antmicro/snapdragon-845-baseboard/(threads)

Thread 2 (2024-04-30):

turbox d845

dzid26, 2024-04-30:
Is it compatible with [turbox d845 som](https://www.thundercomm.com/product/d845-som/)?

pkatarzynski, 2024-05-06:
We have not tested the board with Turbox D845 but this SOM should be pin-compatible

Closed 2024-05-06.
