antmicro/snapdragon-845-baseboard/doc/sa800u-baseboard-hw.pdf

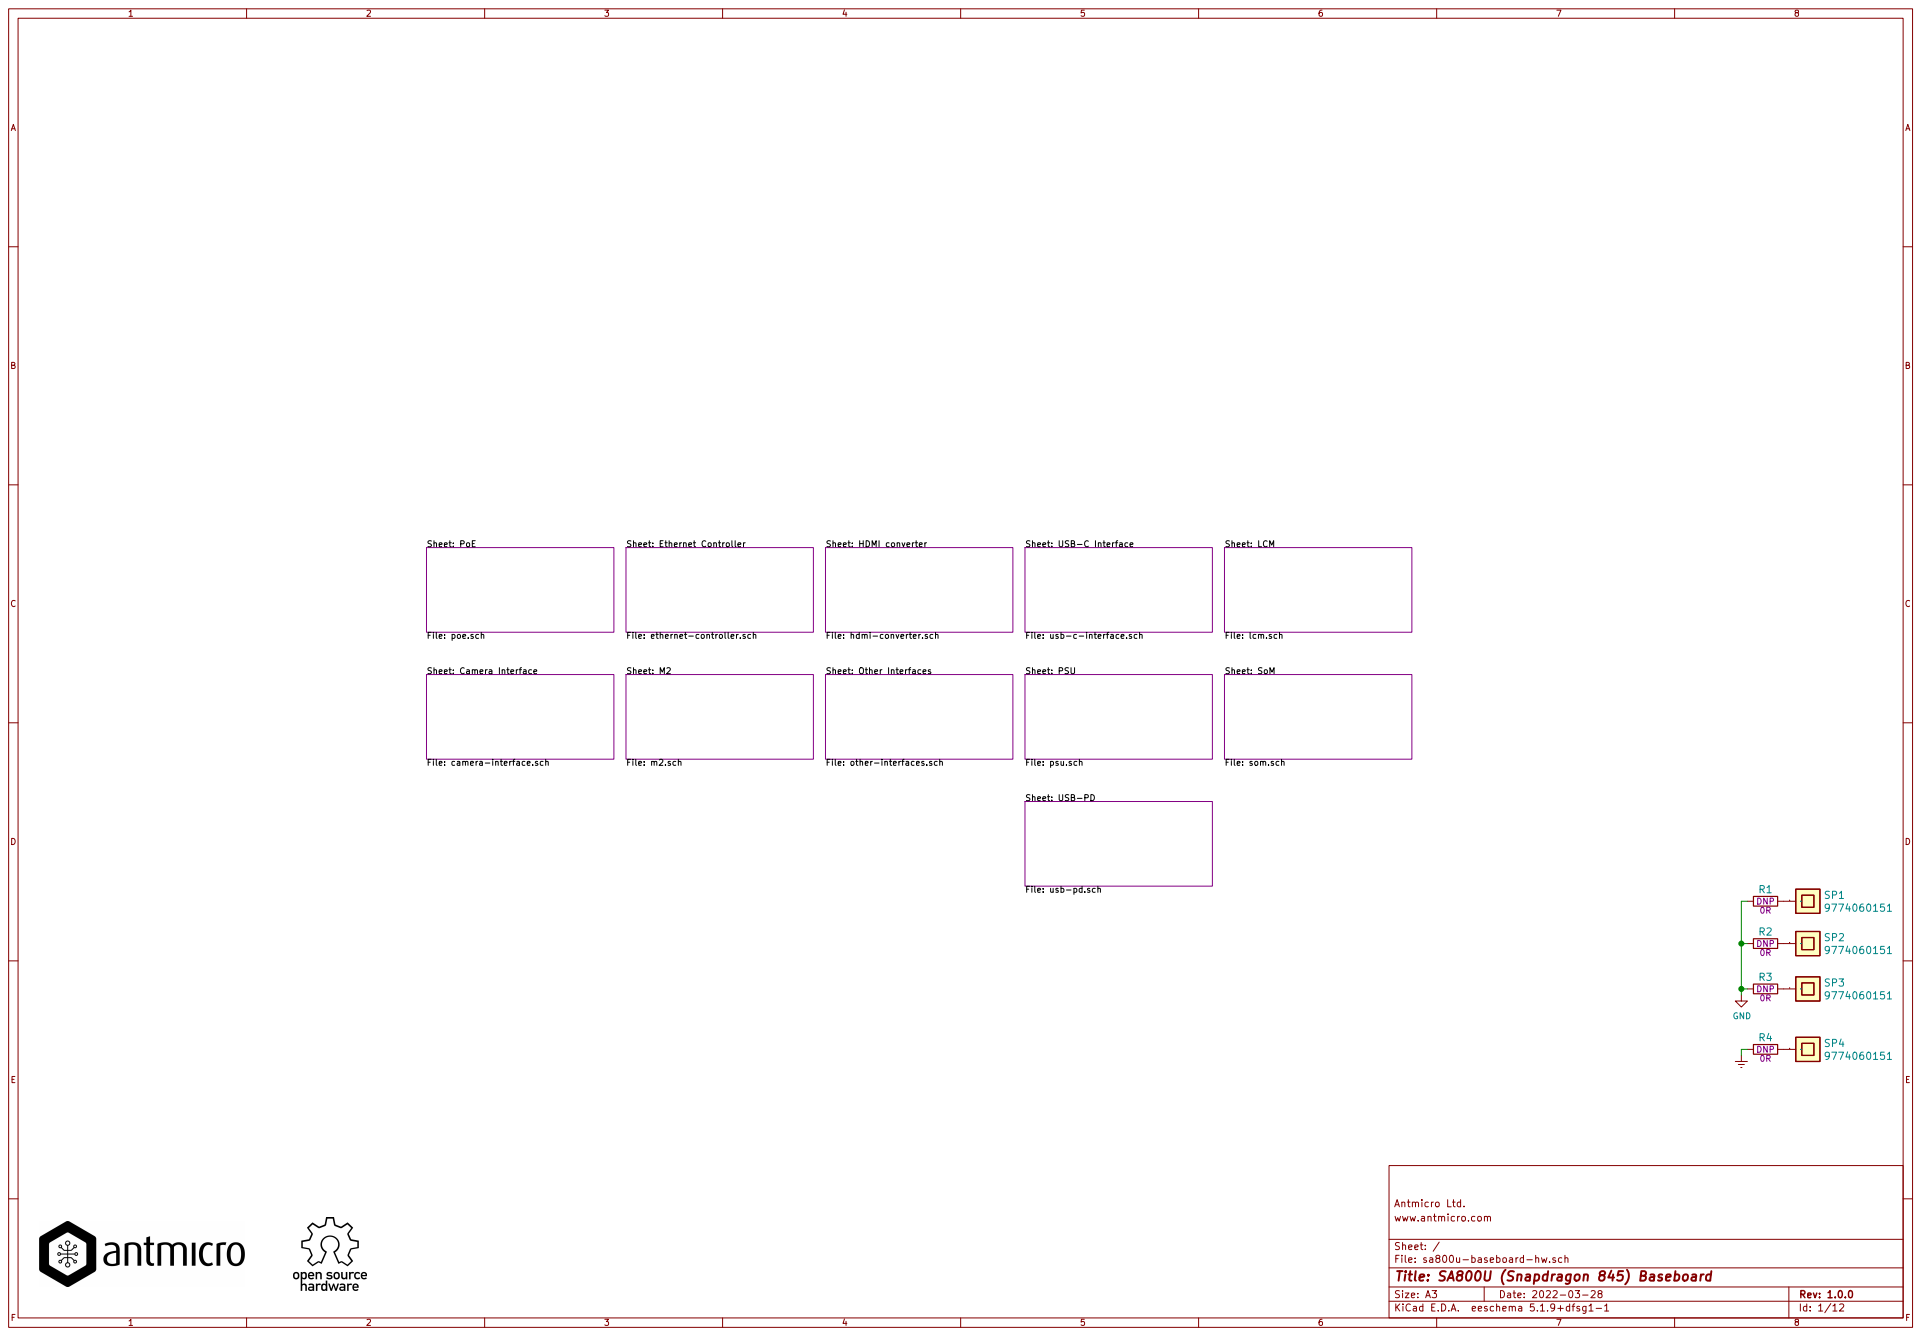
[picture p2: page 1]

File: usb-pd.sch Sheet: PoE

Antmicro Ltd.
File: sa800u-baseboard-hw.sch Sheet: / www.antmicro.com

Id: 1/12 Title: SA800U (Snapdragon 845) Baseboard

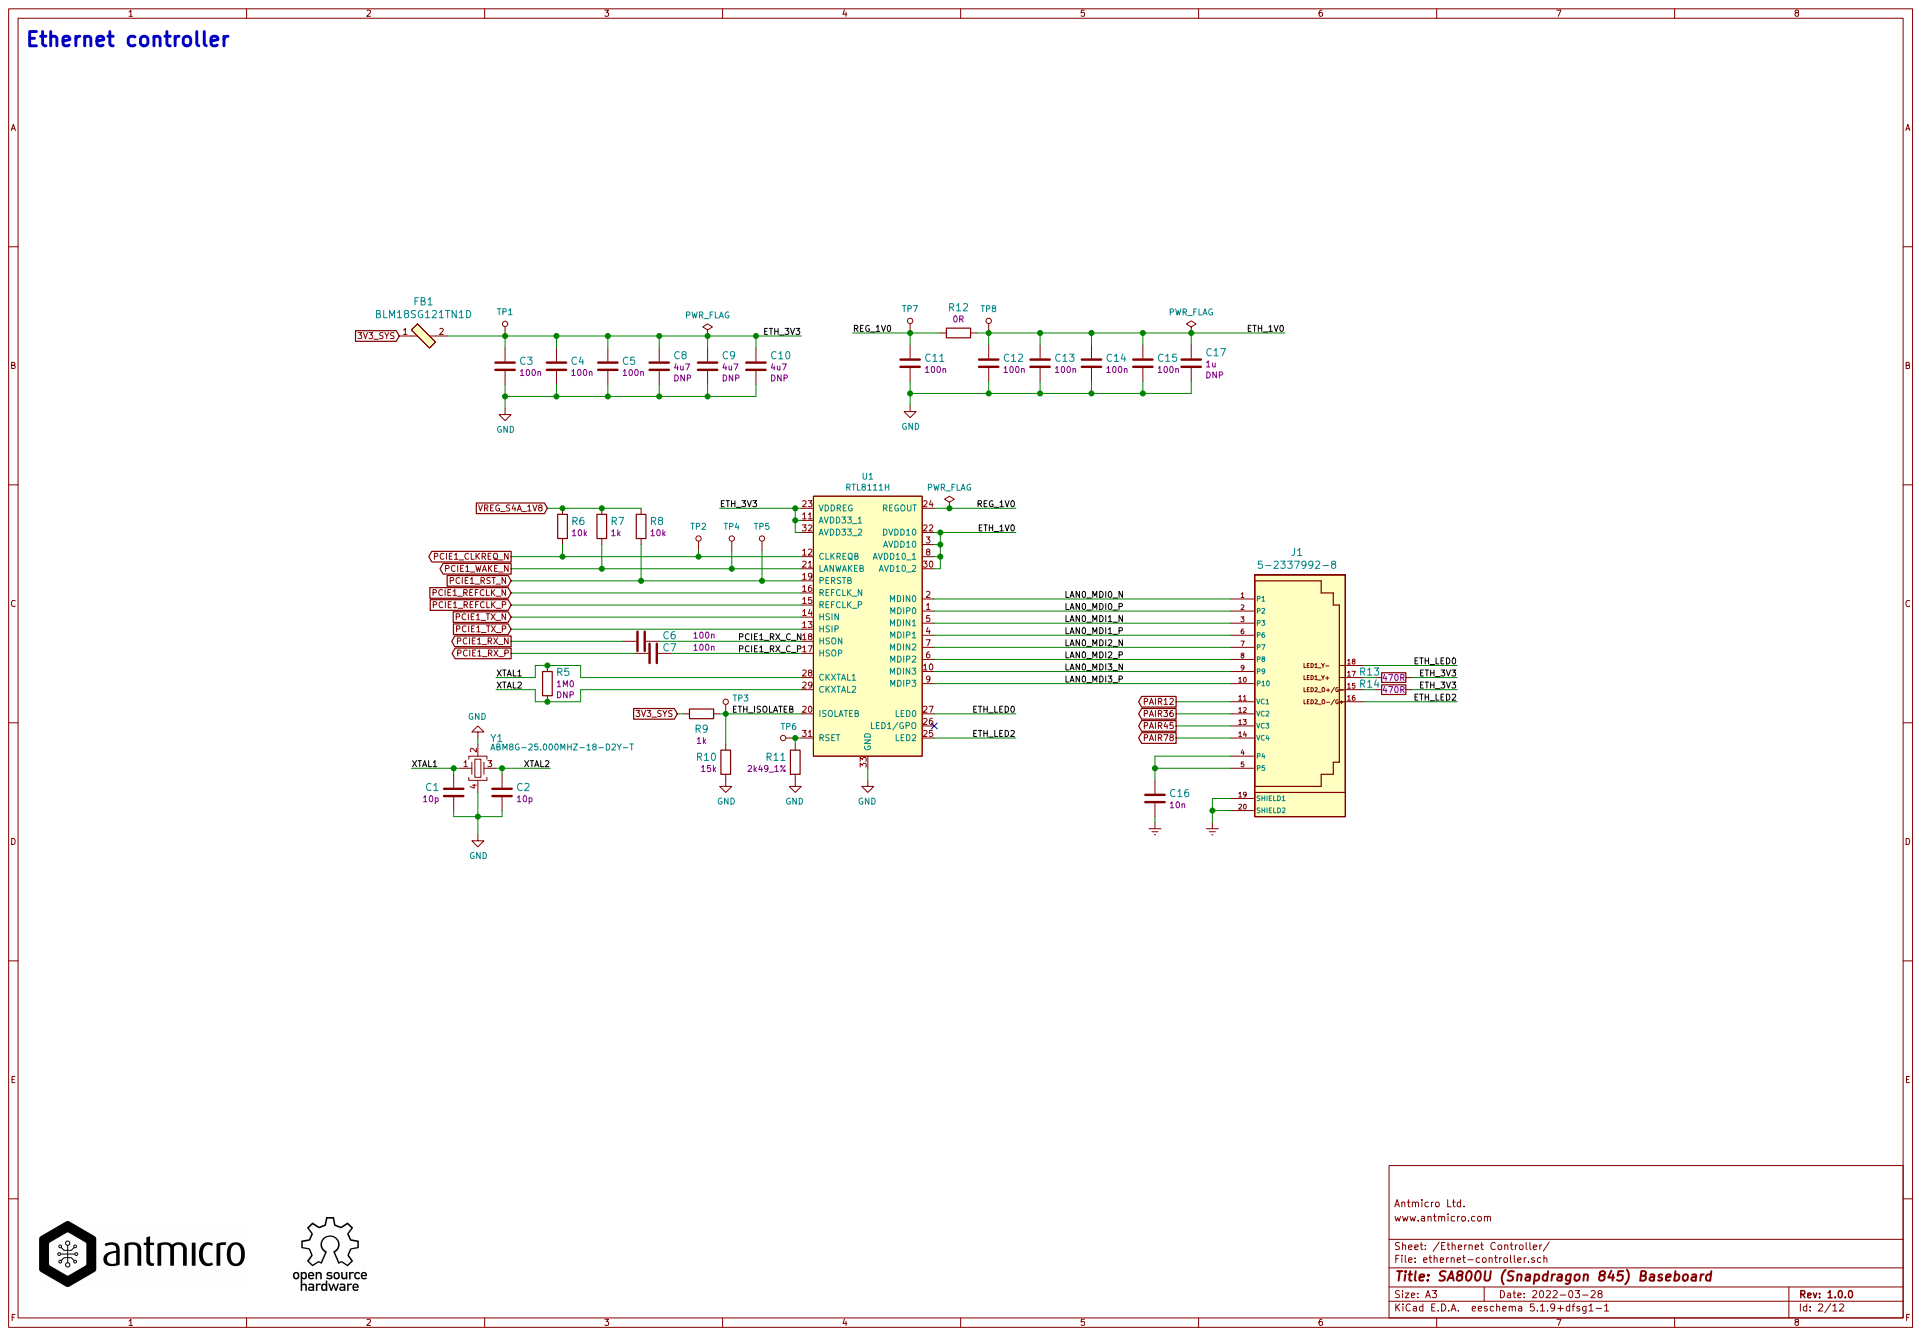
[picture p3: page 2]

Antmicro Ltd.
File: ethernet-controller.sch Sheet: /Ethernet Controller/ www.antmicro.com

Id: 2/12 Title: SA800U (Snapdragon 845) Baseboard

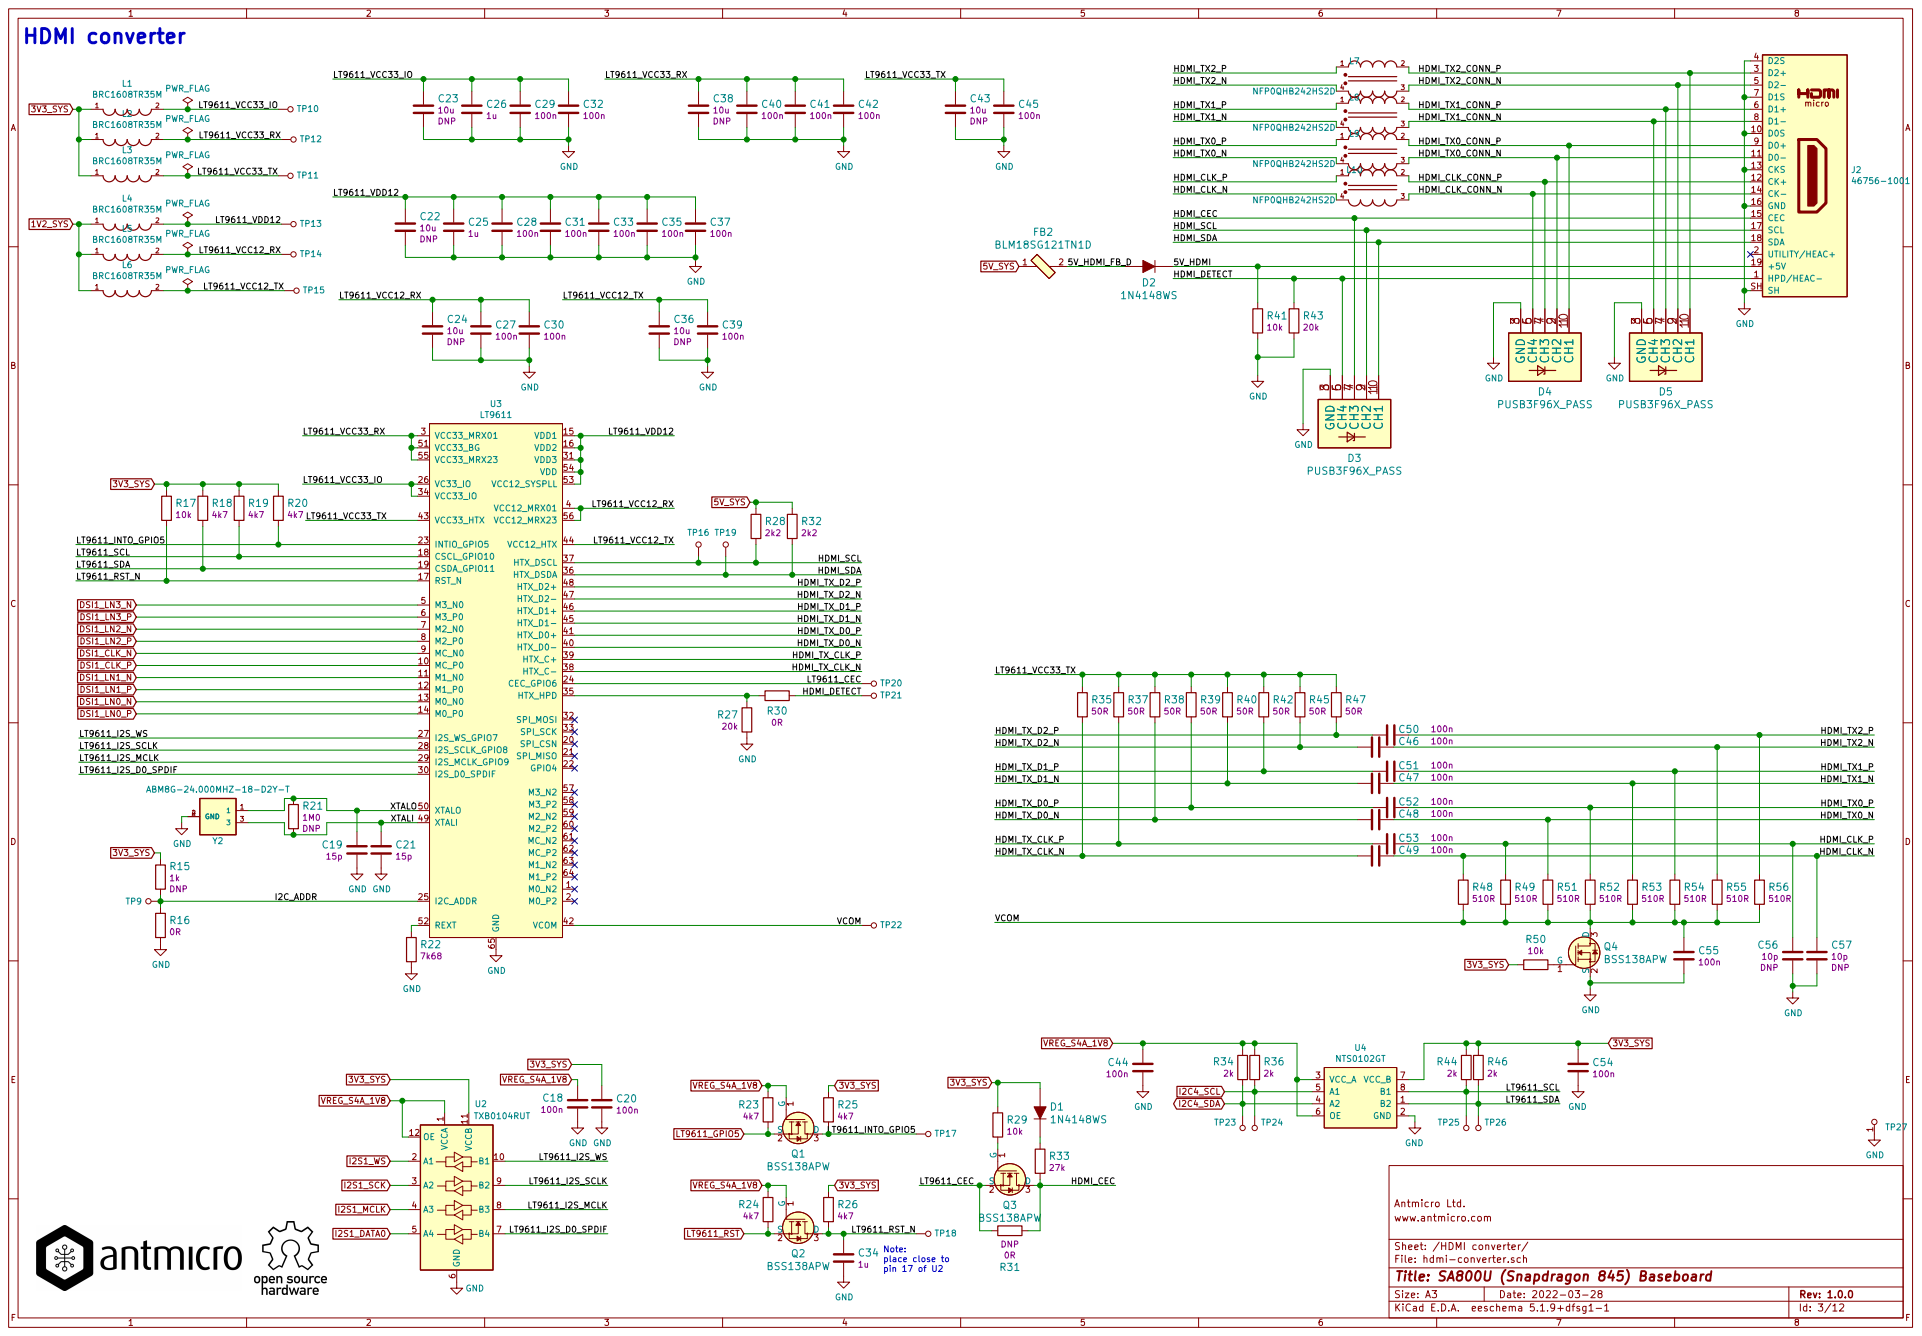
[picture p4: page 3]

File: hdmi-converter.sch Sheet: /HDMI converter/ www.antmicro.com

Note: place close to
pin 17 of U2

Id: 3/12 Title: SA800U (Snapdragon 845) Baseboard

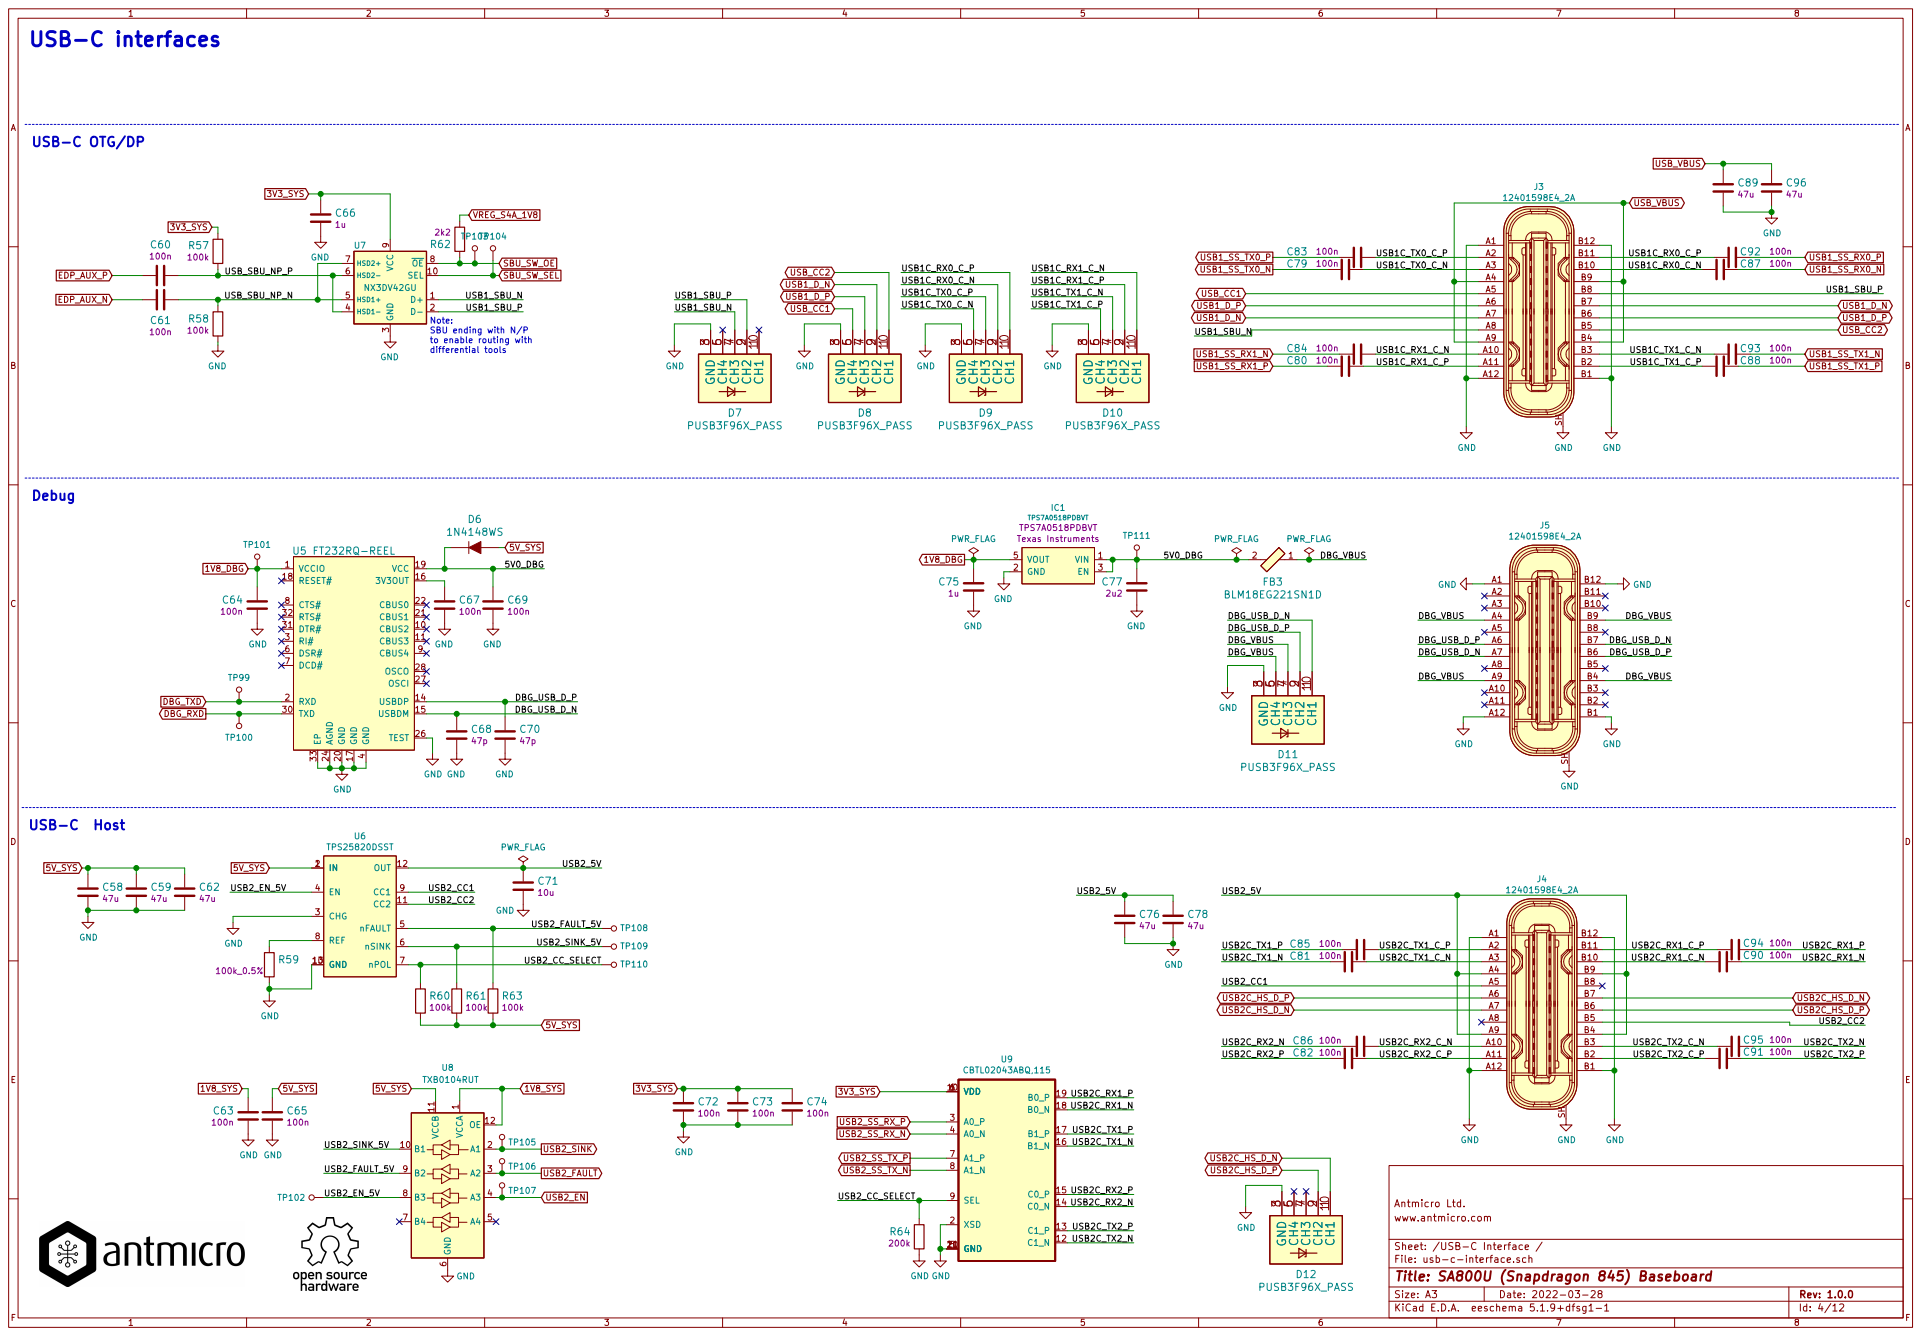
[picture p5: page 4]

Note: SBU ending with N/P

to enable routing with differential tools USB-C Host

4 DSR# 6 DCD# 7 CTS# 8 CBUS4 9 U5 FT232RQ-REEL GND C73

Antmicro Ltd.
File: usb-c-interface.sch Sheet: /USB-C Interface / www.antmicro.com

Id: 4/12 Title: SA800U (Snapdragon 845) Baseboard

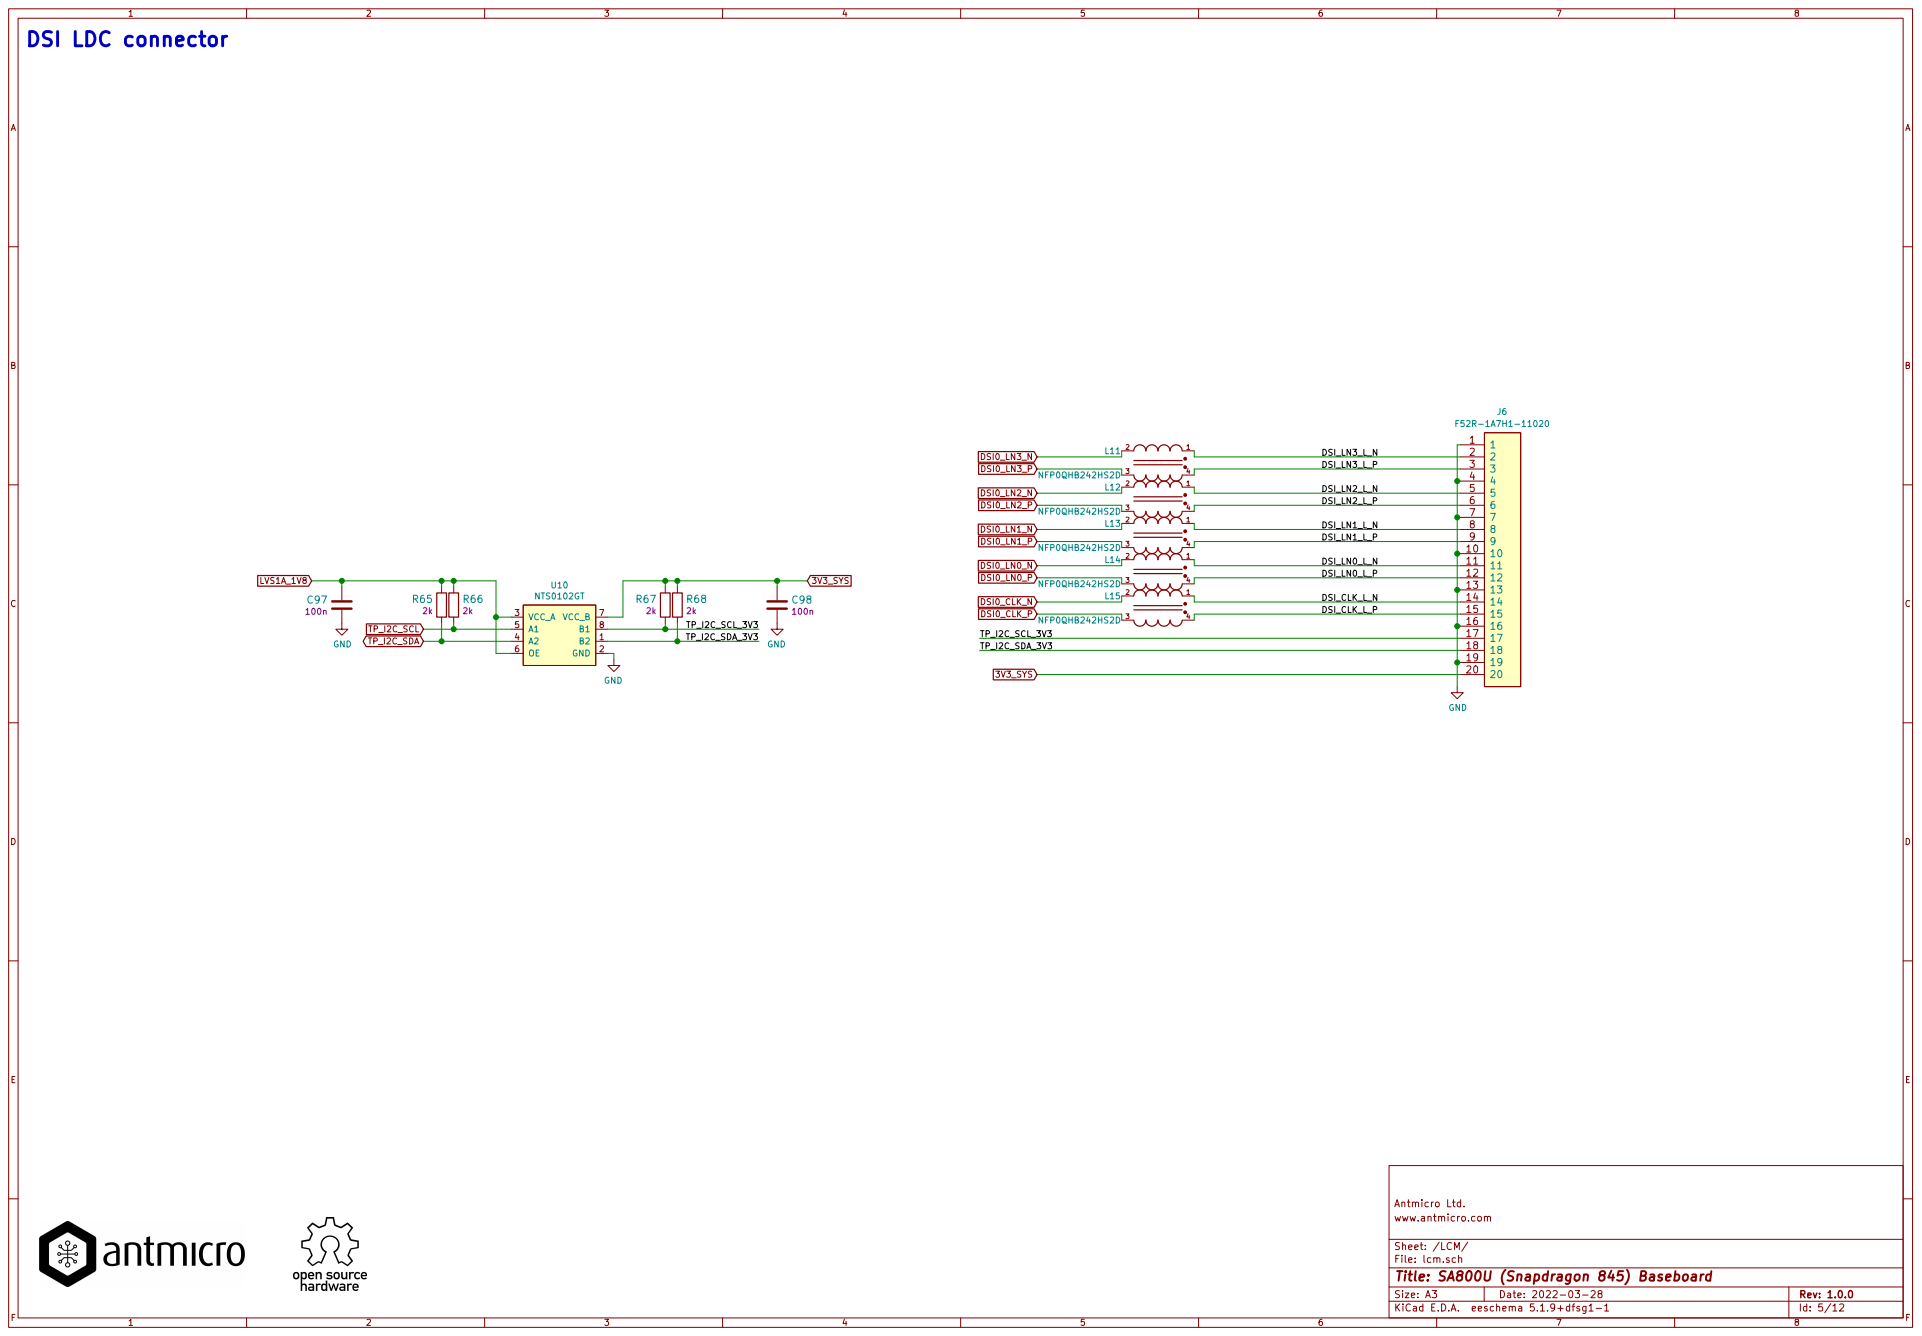
[picture p6: page 5]

Antmicro Ltd.
File: lcm.sch Sheet: /LCM/ www.antmicro.com

Id: 5/12 Title: SA800U (Snapdragon 845) Baseboard

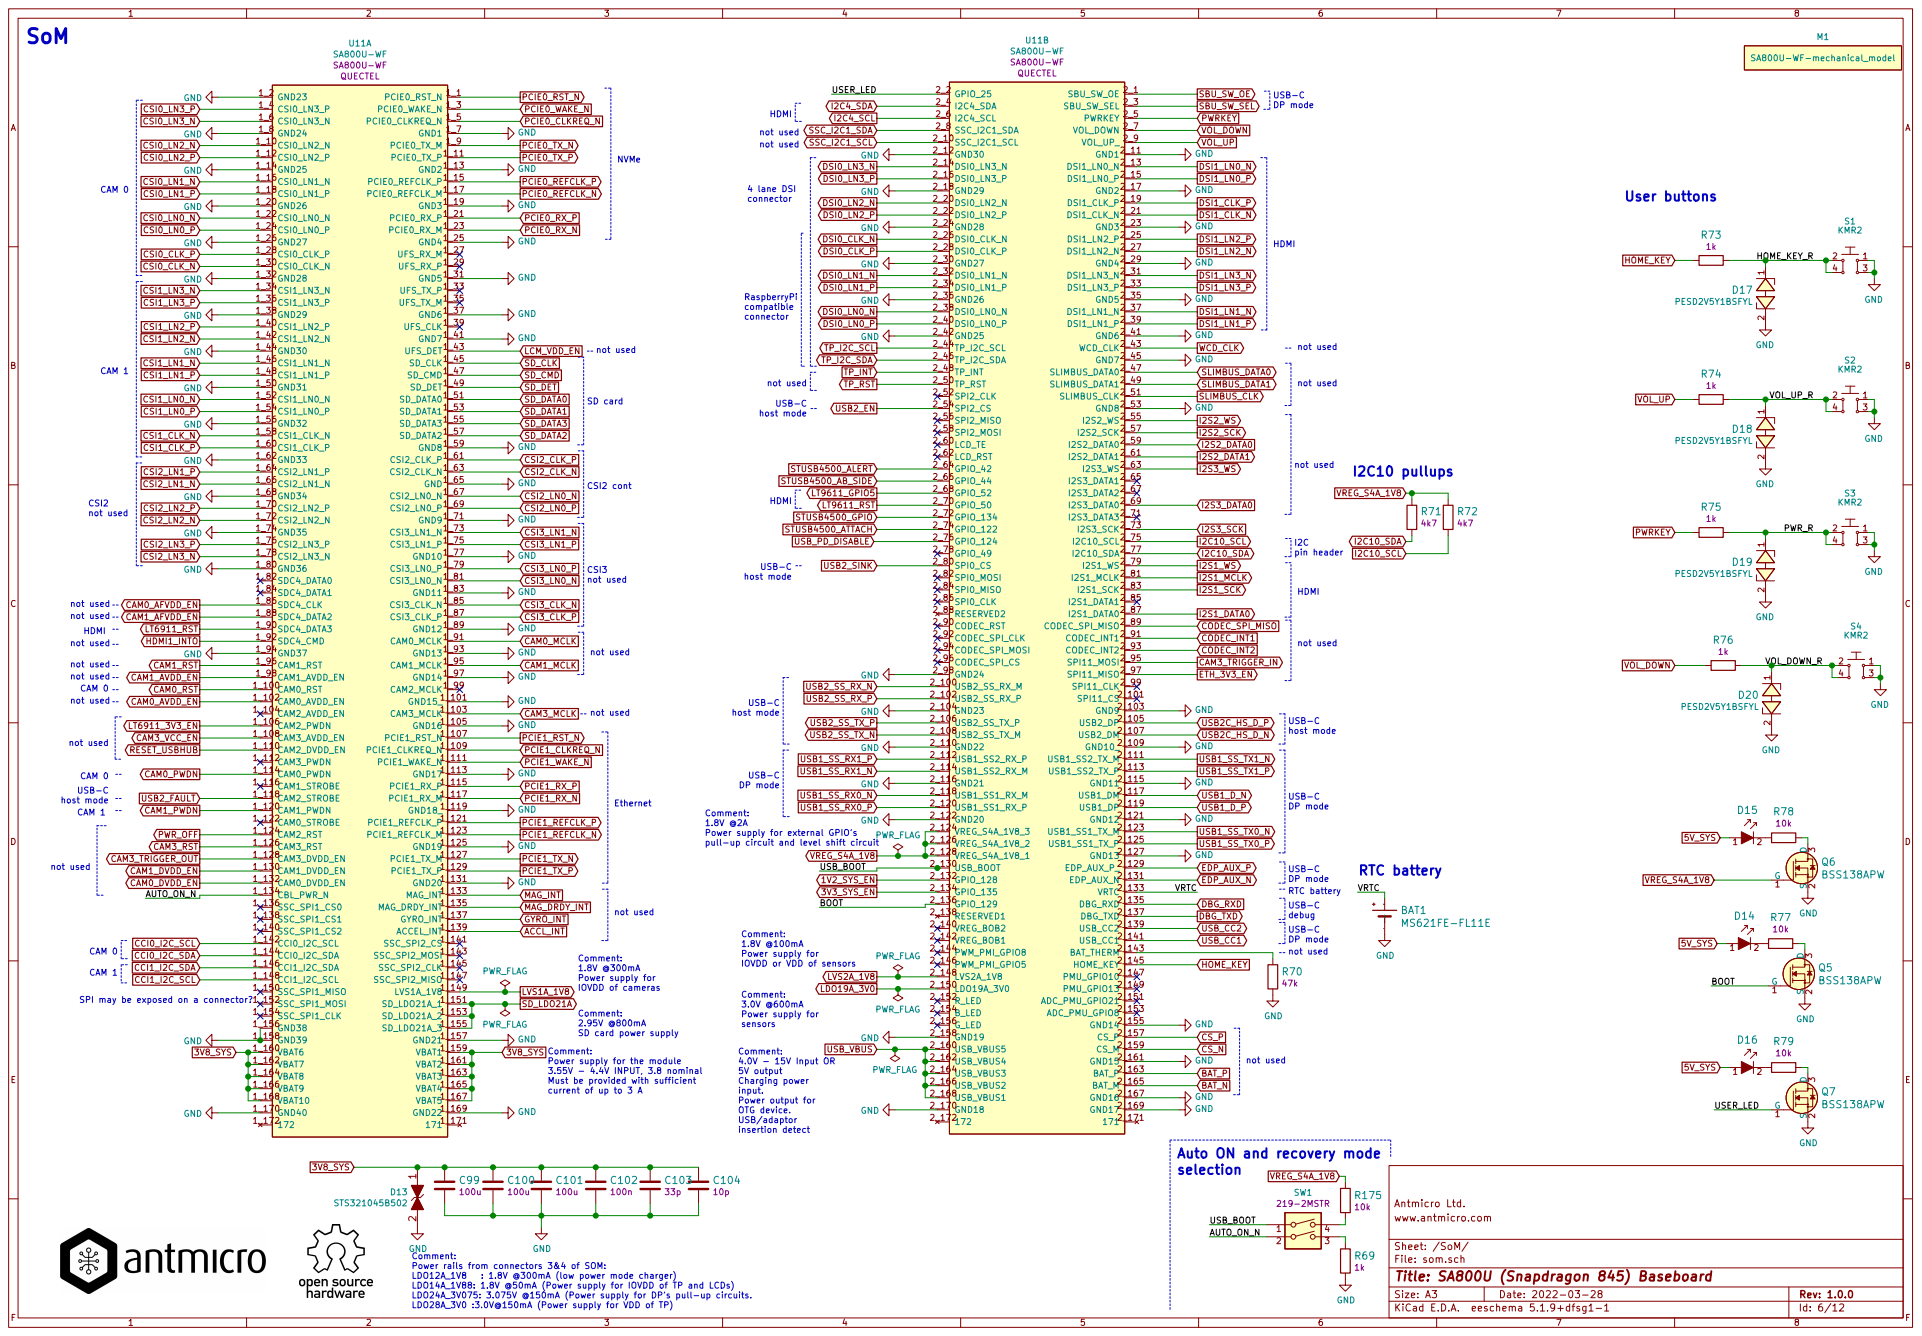
[picture p7: page 6]

SoM
GND GND GND GND GND
SD card CSI2 cont NVMe

VOL_DOWN
GND GND

pull-up circuit and level shift circuit not used CSI3 not used CAM 0

DSI1_LN2_P
HOME_KEY_R Auto ON and recovery mode
GND GND GND
DSI1_LN3_N

host mode HDMI not used

pin header not used CAM 0

DP mode Comment: Power rails from connectors 3&4 of SOM: LDO12A_1V8 : 1.8V @300mA (low power mode charger)

Power supply for external GPIOs

debug Comment: Power supply for the module

Power supply for sensors Comment: 1.8V @100mA
insertion detect Comment: 3.0V @600mA

current of up to 3 A Comment: 1.8V @300mA

IOVDD of cameras SPI may be exposed on a connector?

SD card power supply

3.55V - 4.4V INPUT, 3.8 nominal Must be provided with sufficient

5V output
Charging power
input.
Power output for OTG device. USB/adaptor

Antmicro Ltd.
File: som.sch Sheet: /SoM/ www.antmicro.com

Id: 6/12 Title: SA800U (Snapdragon 845) Baseboard

LDO14A_1V88: 1.8V @50mA (Power supply for IOVDD of TP and LCDs)
LDO24A_3V075: 3.075V @150mA (Power supply for DPs pull-up circuits.
LDO28A_3V0 :3.0V@150mA (Power supply for VDD of TP)

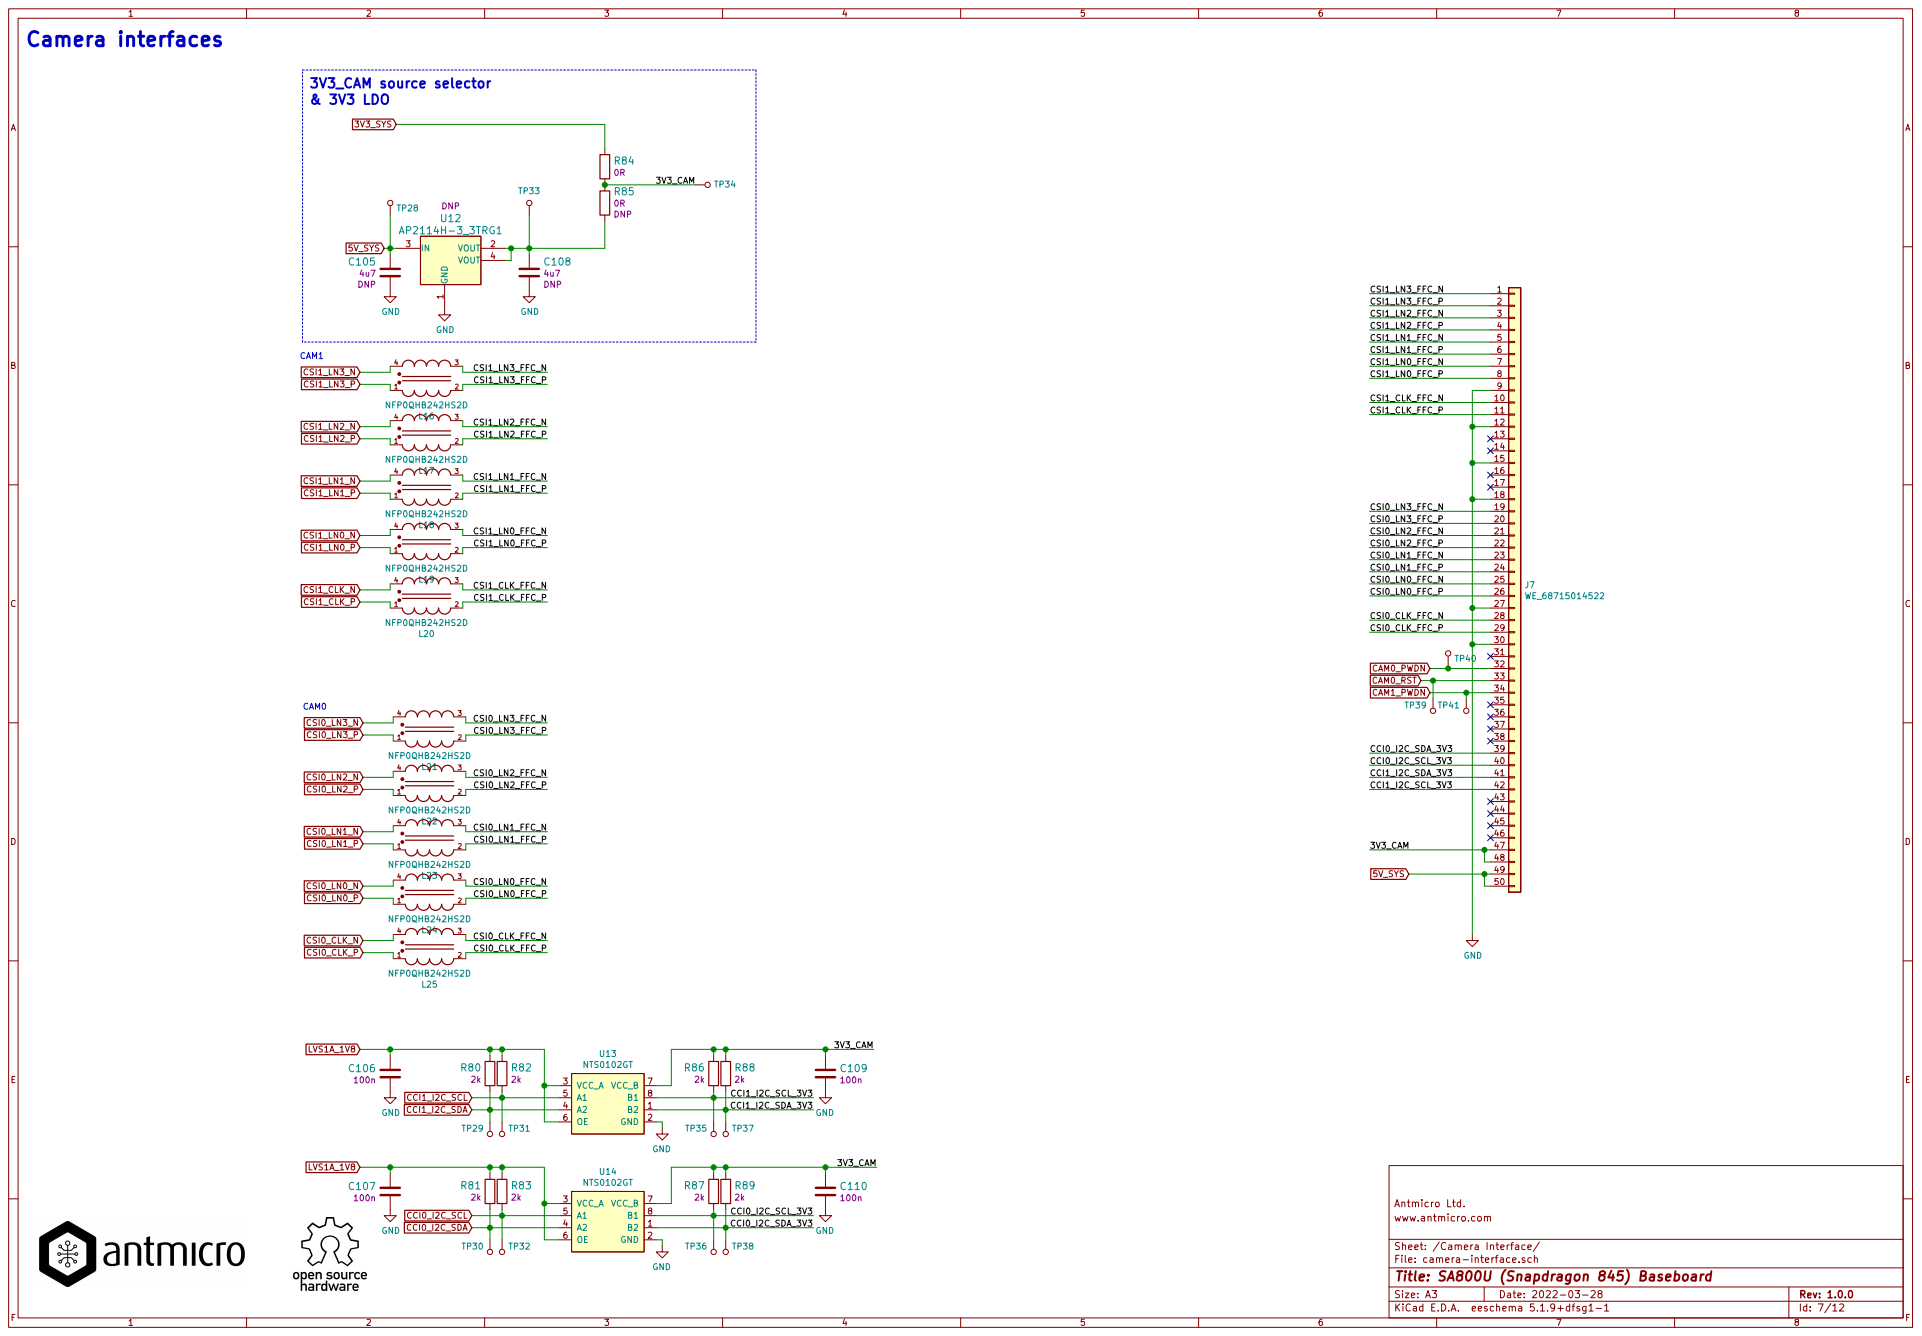
[picture p8: page 7]

34
35

File: camera-interface.sch Sheet: /Camera Interface/ www.antmicro.com

Id: 7/12 Title: SA800U (Snapdragon 845) Baseboard

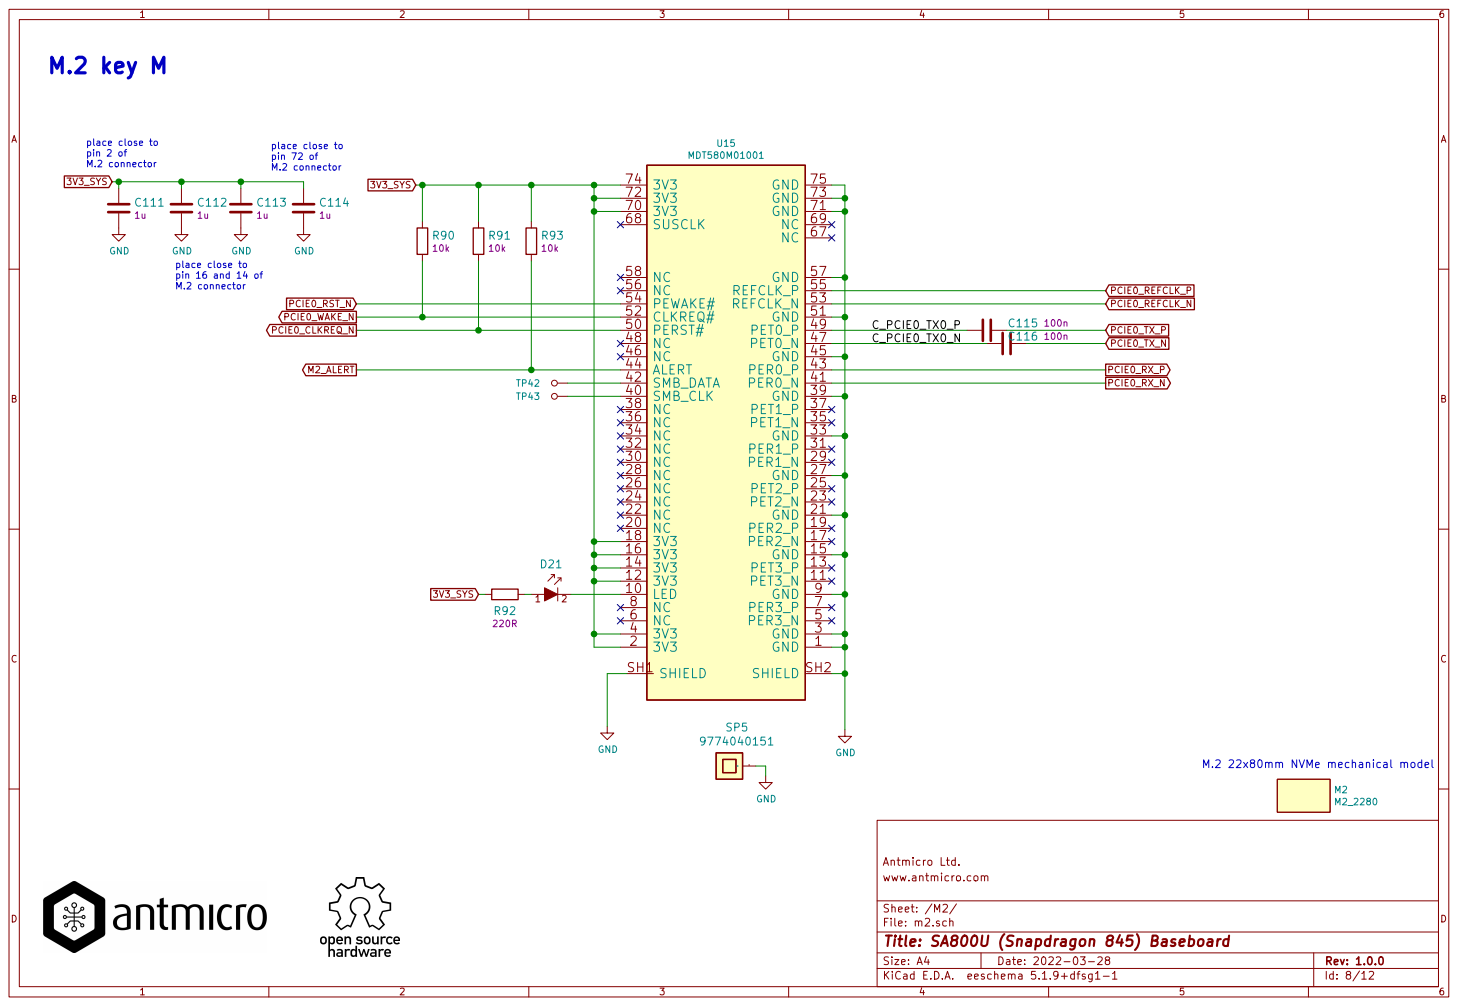
[picture p9: page 8]

Antmicro Ltd.
File: m2.sch Sheet: /M2/ www.antmicro.com

Id: 8/12 Title: SA800U (Snapdragon 845) Baseboard

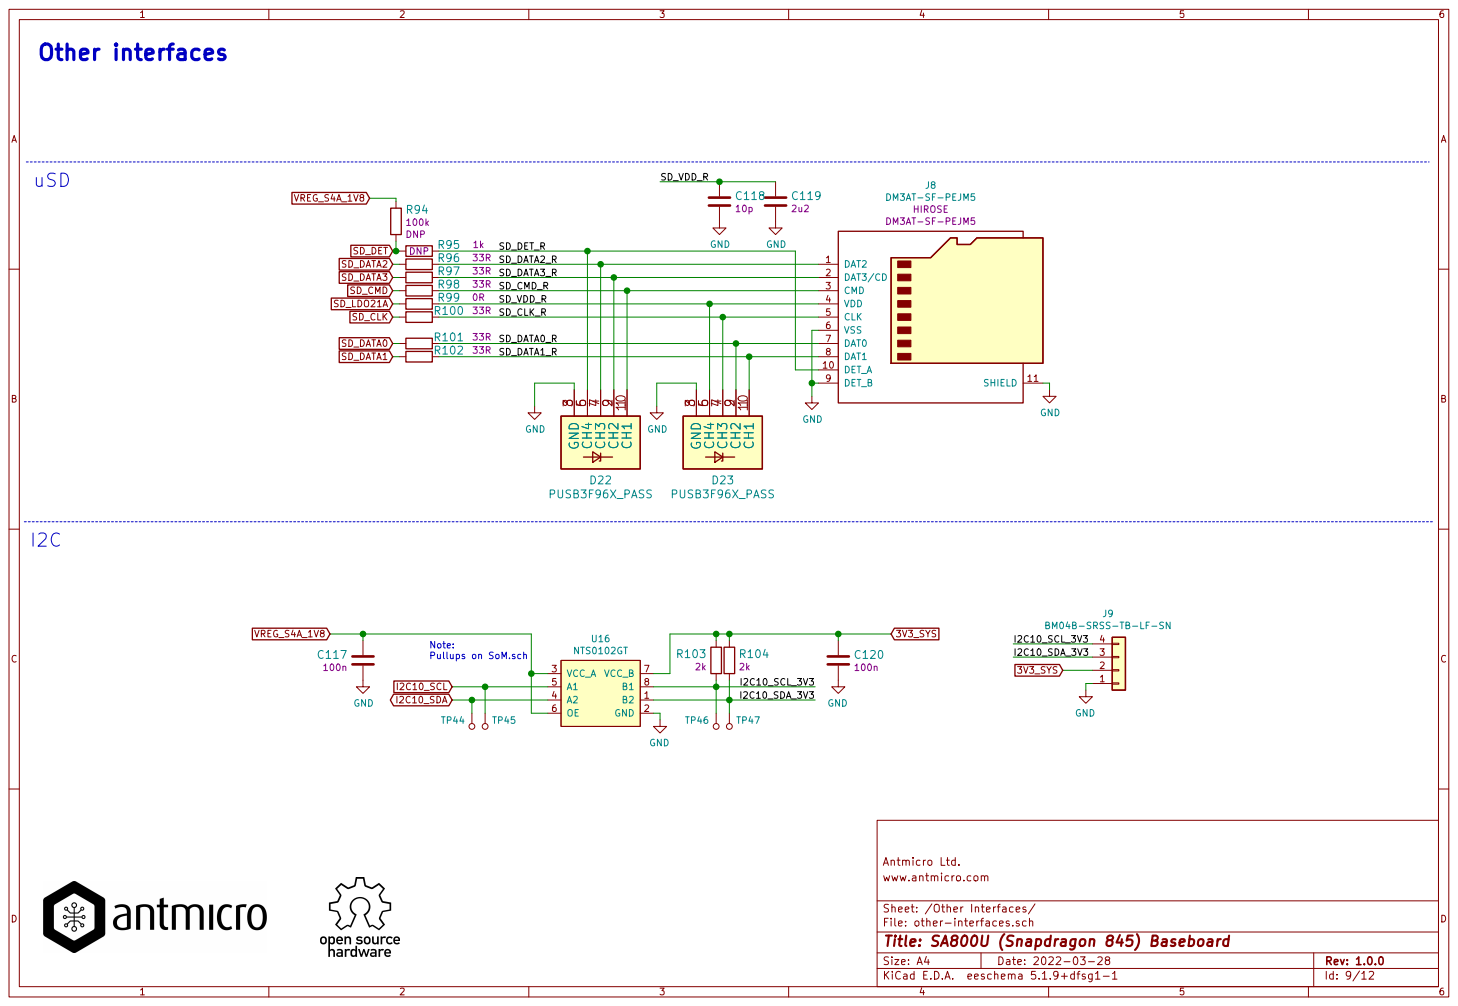
[picture p10: page 9]

J8 DM3AT-SF-PEJM5 HIROSE DM3AT-SF-PEJM5 GND C119
2u2 GND

J9 BM04B-SRSS-TB-LF-SN CH1

Note: Pullups on SoM.sch

File: other-interfaces.sch Sheet: /Other Interfaces/ www.antmicro.com

Id: 9/12 Title: SA800U (Snapdragon 845) Baseboard

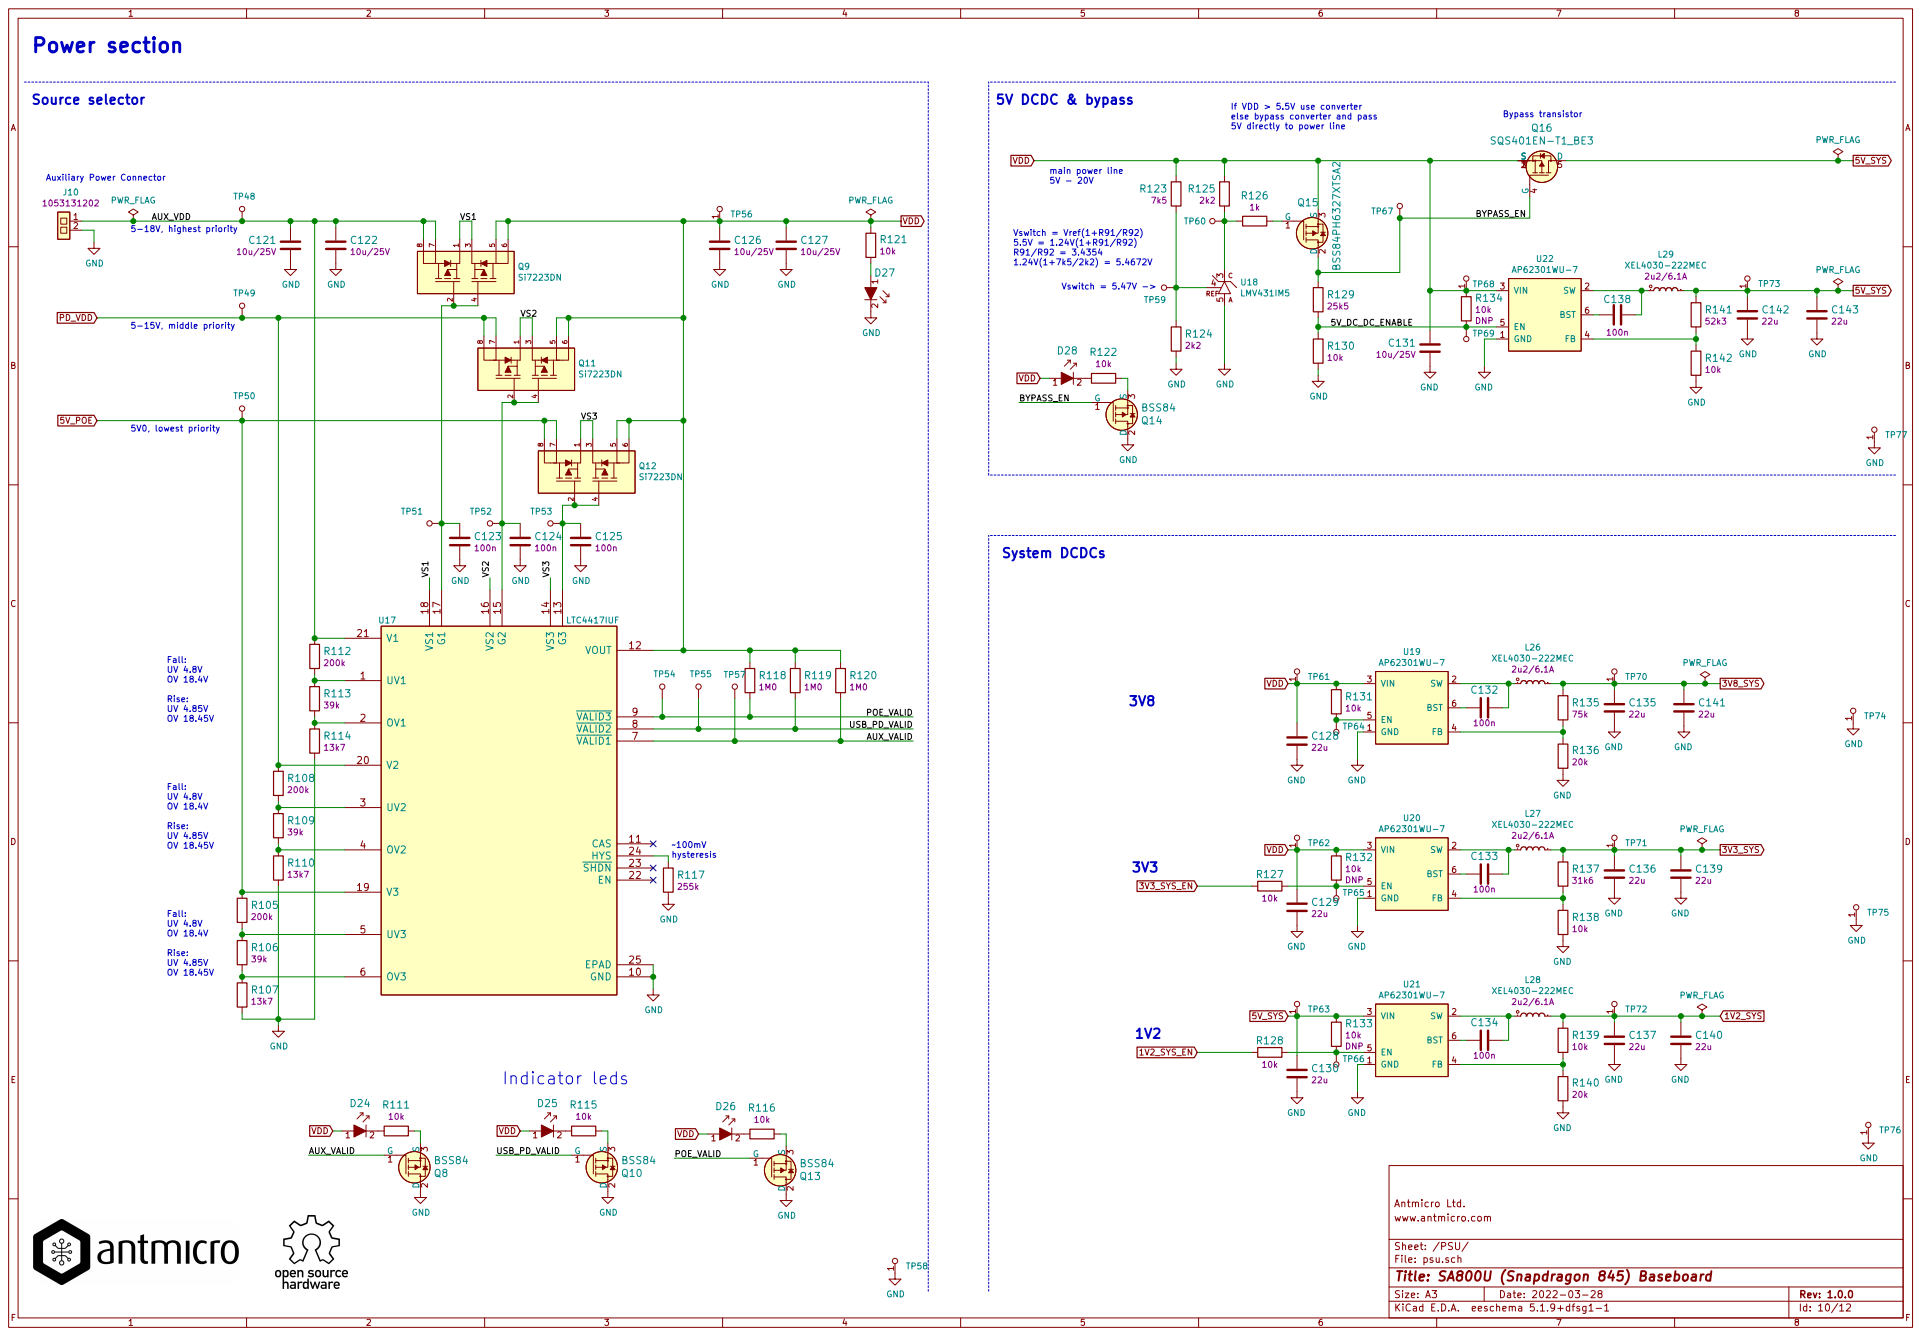
[picture p11: page 10]

If VDD > 5.5V use converter else bypass converter and pass

5V directly to power line

Fall: UV 4.8V OV 18.4V Rise: UV 4.85V OV 18.45V

Antmicro Ltd.
File: psu.sch Sheet: /PSU/ www.antmicro.com

Id: 10/12 Title: SA800U (Snapdragon 845) Baseboard

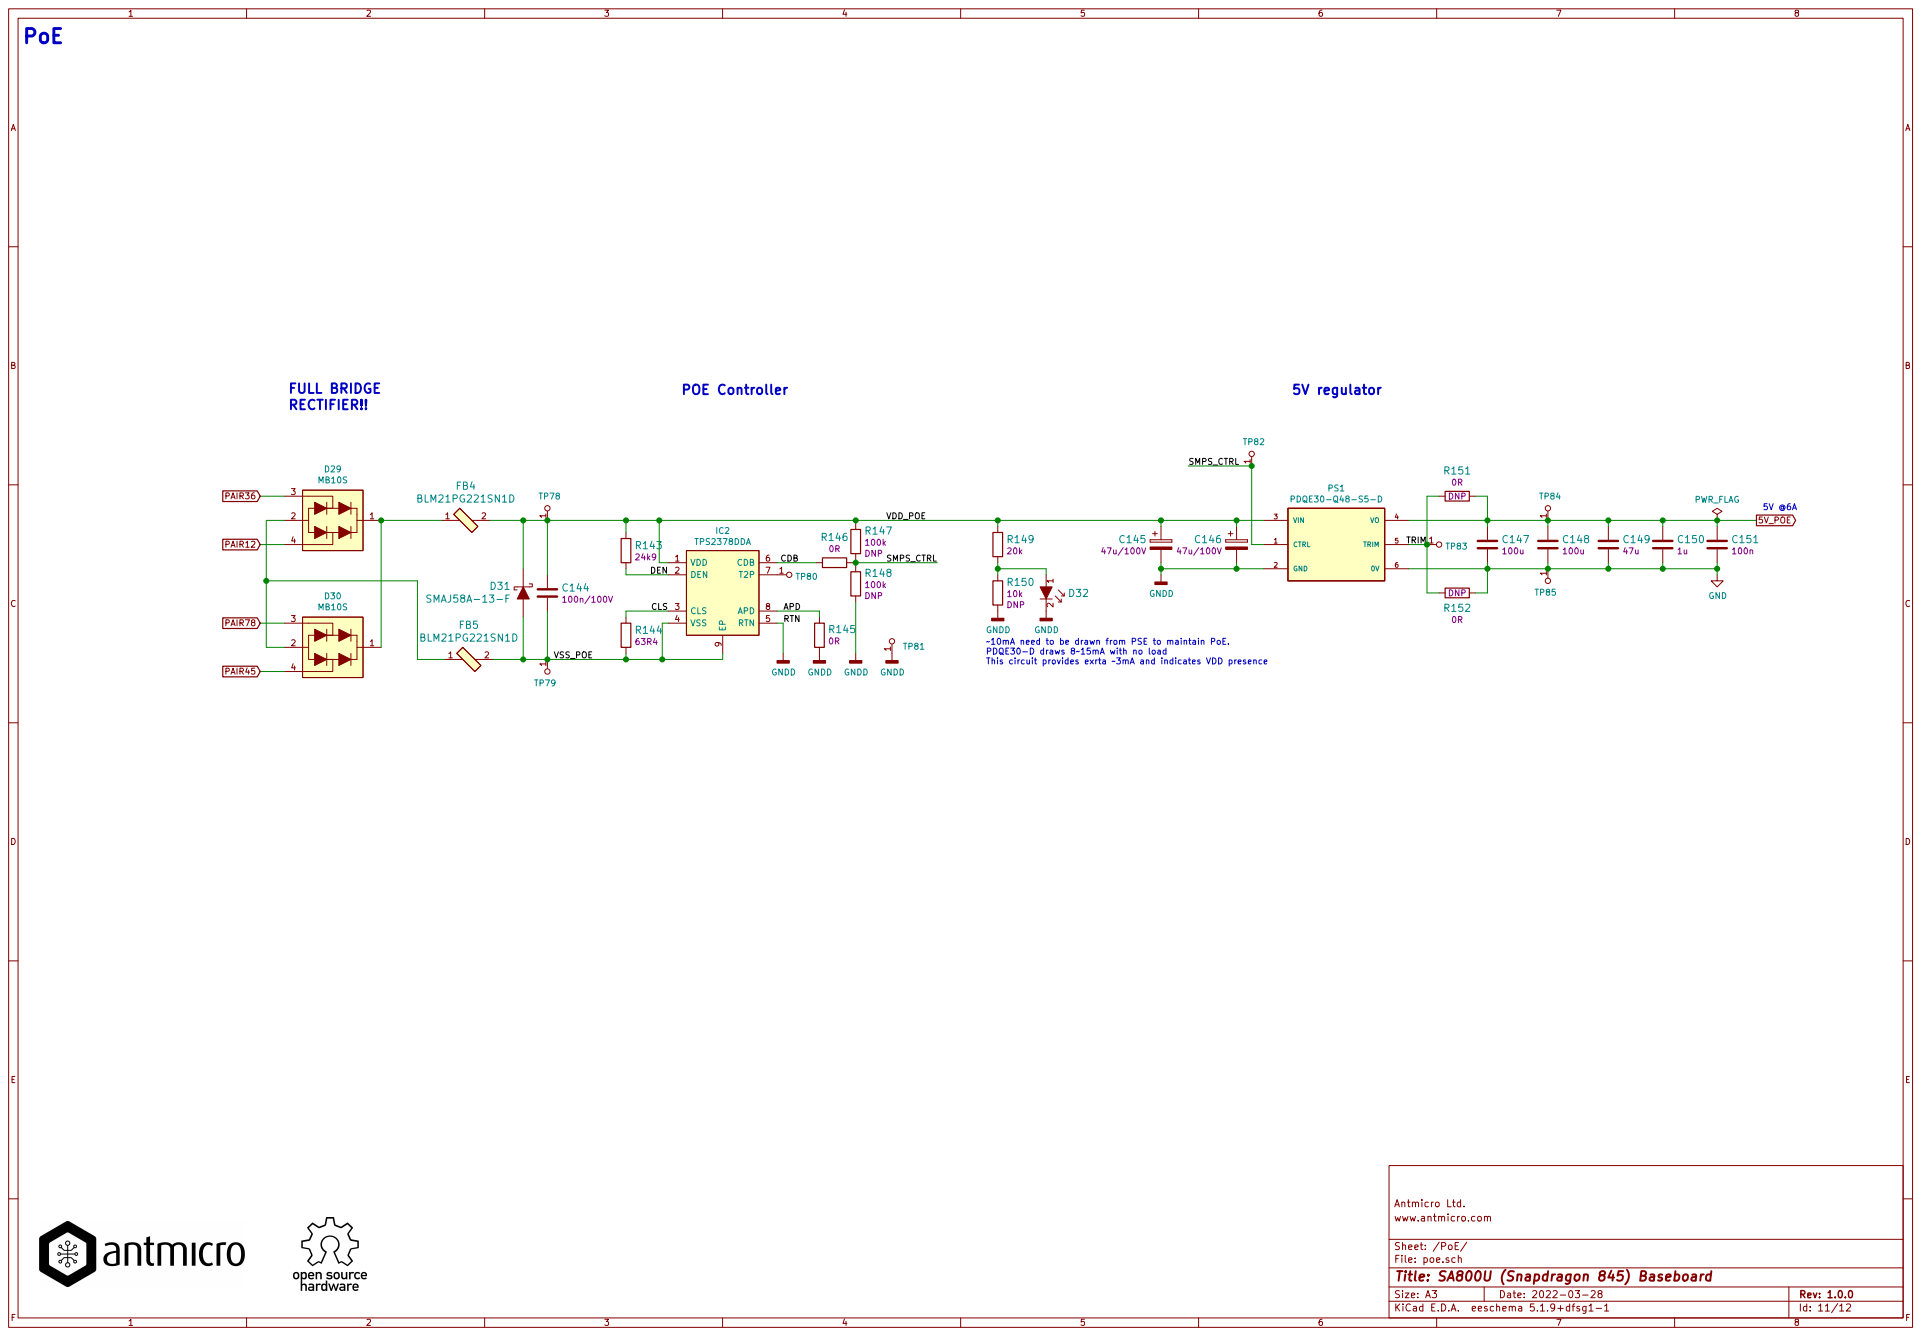
[picture p12: page 11]

10mA need to be drawn from PSE to maintain PoE. PDQE30-D draws 815mA with no load This circuit provides exrta 3mA and indicates VDD presence

Antmicro Ltd.
File: poe.sch Sheet: /PoE/ www.antmicro.com

Id: 11/12 Title: SA800U (Snapdragon 845) Baseboard

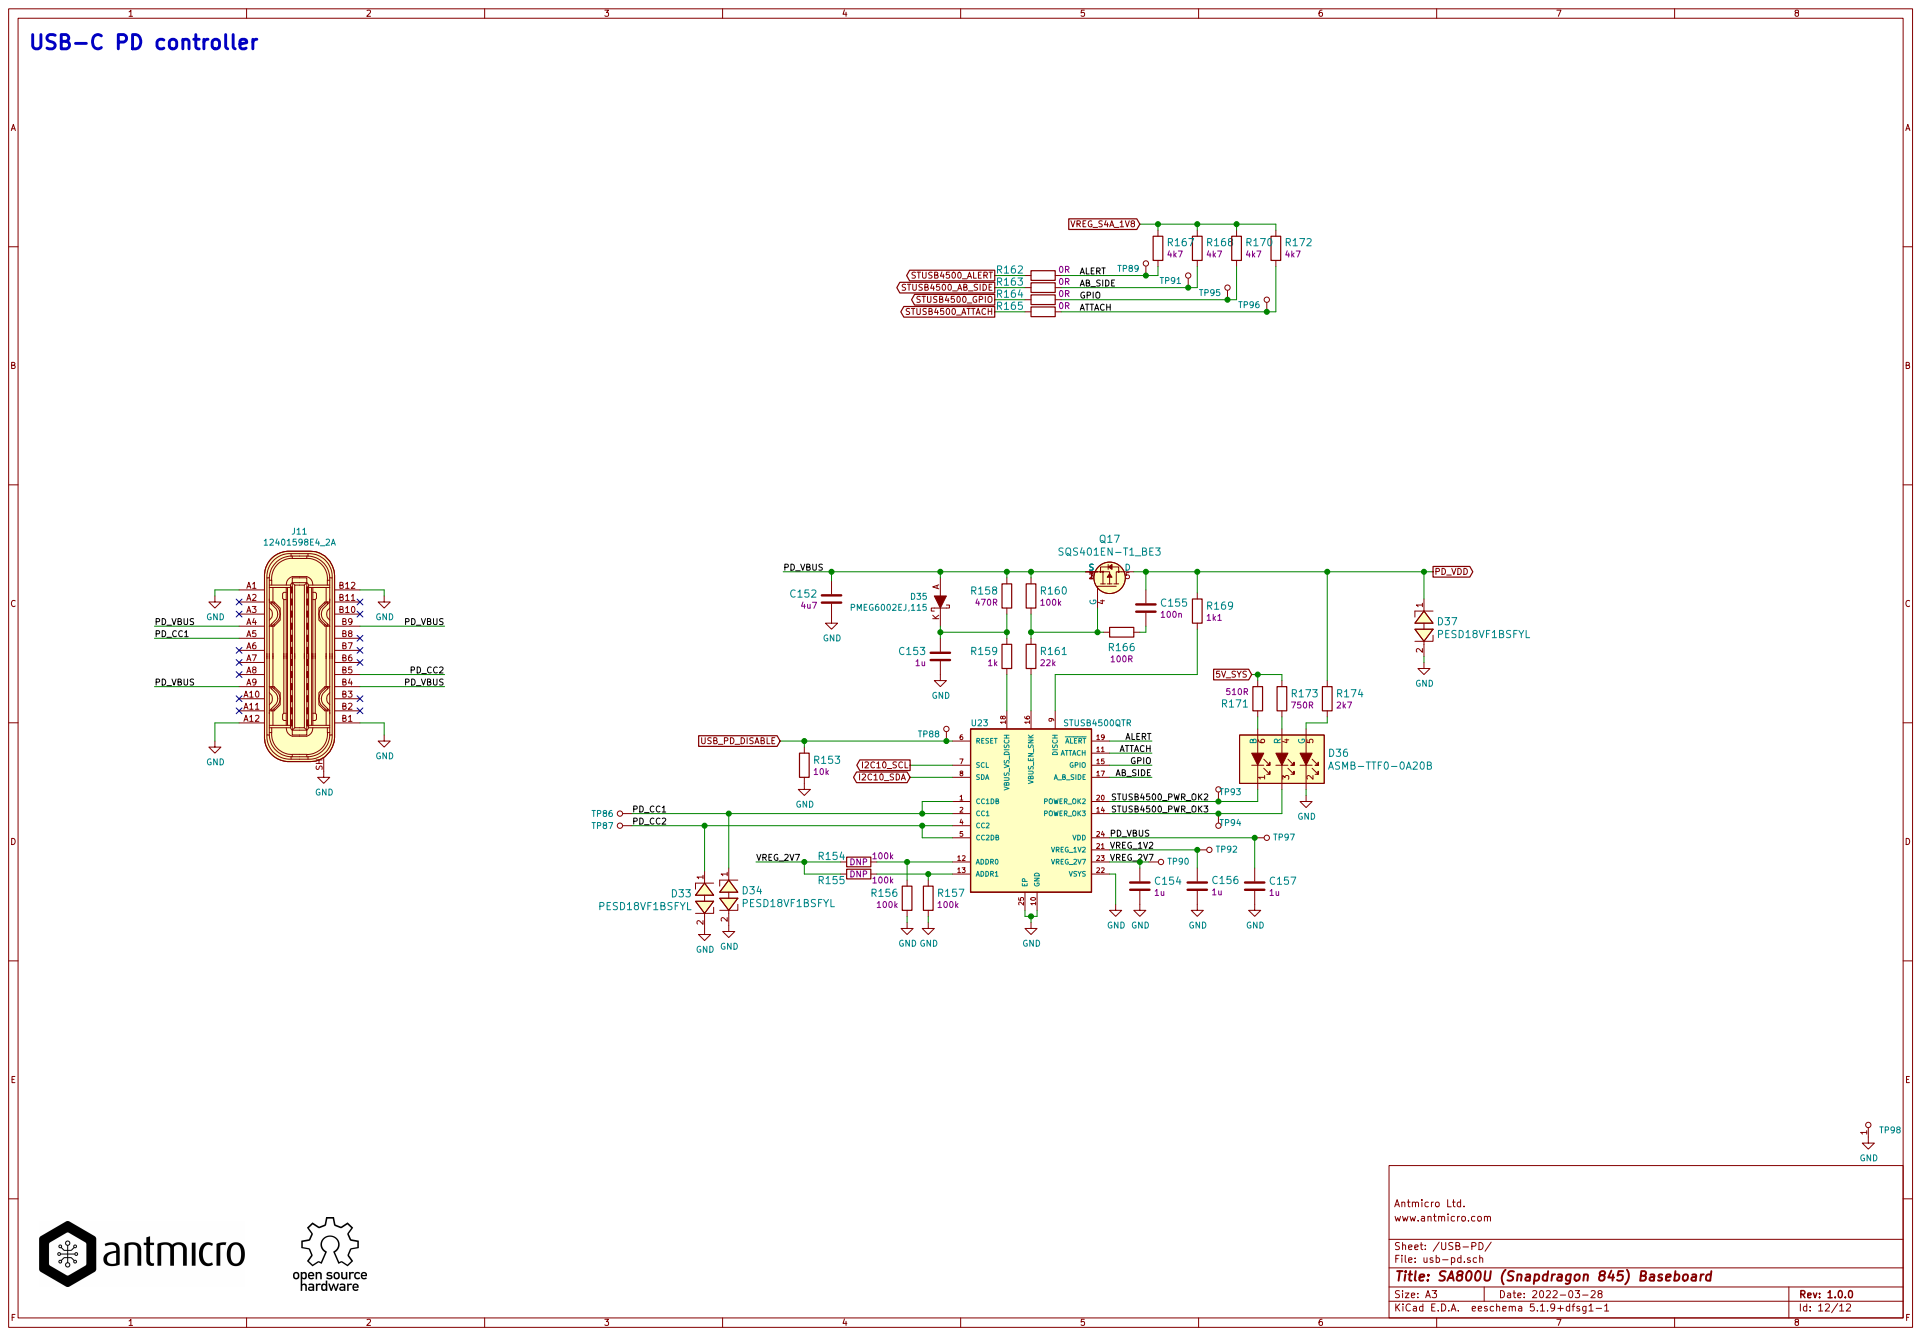
[picture p13: page 12]

Antmicro Ltd.
File: usb-pd.sch Sheet: /USB-PD/ www.antmicro.com

Id: 12/12 Title: SA800U (Snapdragon 845) Baseboard
