antmicro/snapdragon-845-baseboard/sa800u-baseboard-hw.kicad_pcb

## KiCad design sa800u-baseboard-hw.kicad_pcb (2022-03-28)

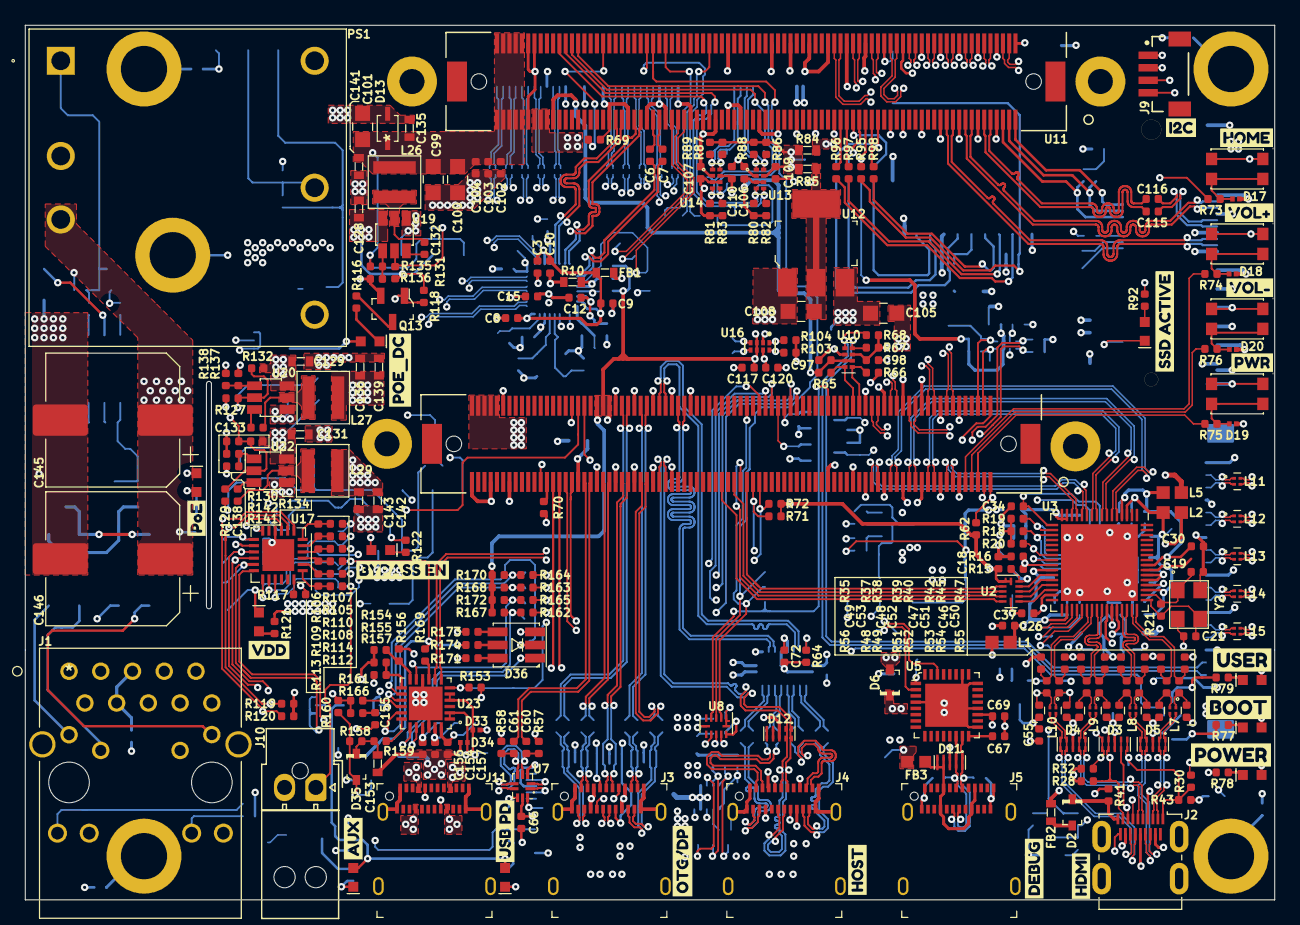
[picture p14: board sa800u-baseboard-hw.kicad_pcb from above]

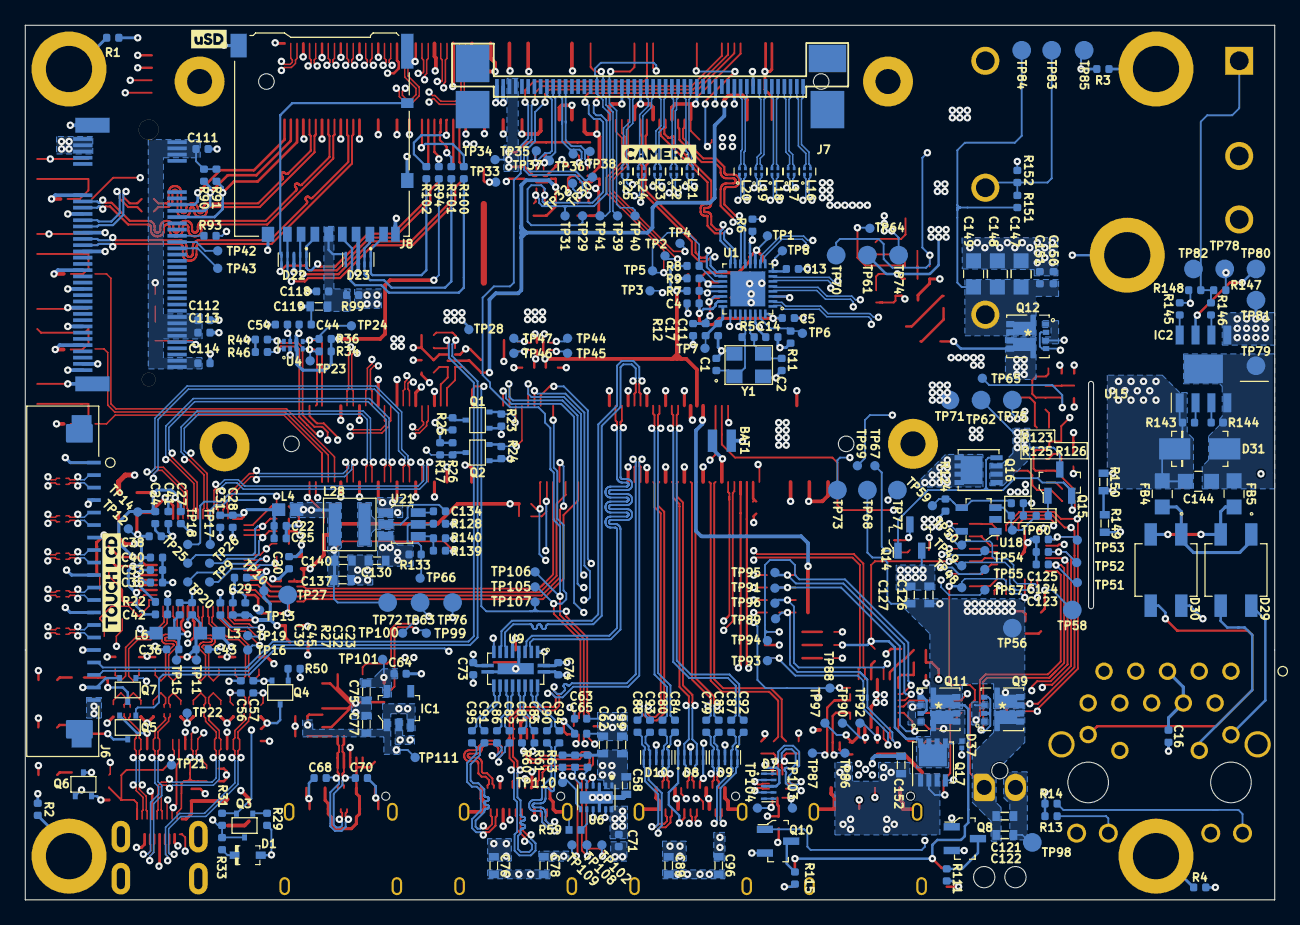
[picture p15: board sa800u-baseboard-hw.kicad_pcb from below]

Board: 6 copper layers, 100.0 x 70.0 mm, 603 parts (327 on the bottom side), 418 nets.

Parts:
BAT1: MS621FE-FL11E
C1, C2, C56, C57, C104, C118: C_10p_0402; 0402-cap
C3, C4, C5, C6, C7, C11, C12, C13, C14, C15, C18, C20, C27, C28, C29, C30, C31, C32, C33, C35, C37, C39, C40, C41, C42, C44, C45, C46, C47, C48, C49, C50, C51, C52, C53, C54, C55, C60, C61, C63, C64, C65, C67, C69, C72, C73, C74, C79, C80, C81, C82, C83, C84, C85, C86, C87, C88, C90, C91, C92, C93, C94, C95, C97, C98, C102, C106, C107, C109, C110, C115, C116, C117, C120, C123, C124, C125, C132, C133, C134, C138, C151, C155: C_100n_0402; 0402-cap
C8, C9, C10: C_4u7_0402; 0402-cap
C16: C_10n_0402; 0402-cap
C17, C25, C26, C34, C66, C111, C112, C113, C114, C150, C154, C156, C157: C_1u_0402; 0402-cap
C19, C21: C_15p_0402; 0402-cap
C22, C23, C24, C36, C38, C43, C71: C_10u_0402; 0402-cap
C58, C59, C62, C76, C78, C89, C96: C_47u_0603; 0603-cap
C68, C70: C_47p_0402; 0402-cap
C75, C153: C_1u_0603; 0603-cap
C77, C119: C_2u2_0603; 0603-cap
C99, C100, C101, C147, C148: C_100u_0805; 0805-cap
C103: C_33p_0402; 0402-cap
C105, C108: C_4u7_0805; 0805-cap
C121, C122, C126, C127, C131: C_10u_25V_0603; 0603-cap
C128, C129, C130, C135, C136, C137, C139, C140, C141, C142, C143: C_22u_0603; 0603-cap
C144: C_100n_0805_100V; 0805-cap
C145, C146: C_47u_ELEC_100V; CP_Elec_10x10.5
C149: C_47u_0805; 0805-cap
C152: C_4u7_0603; 0603-cap
D1, D2, D6: 1N4148WS; SOD-323F
D3, D4, D5, D7, D8, D9, D10, D11, D12, D22, D23: PUSB3F96X_PASS; PUSB3F96X
D13: STS321045B502
D14, D15, D16, D21, D24, D25, D26, D27, D28, D32: KP-1608EC; LED_0603
D17, D18, D19, D20: PESD2V5Y1BSFYL; RESC0603X26N
D29, D30: MB10S
D31: SMAJ58A-13-F; DO-214AC
D33, D34, D37: PESD18VF1BSFYL; RESC0603X26N
D35: PMEG6002EJ,115; SOD-323F
D36: ASMB-TTF0-0A20B; PLCC6_3.5x3.7mm
FB1, FB2: BLM18SG121TN1D; 0603-res
FB3: BLM18EG221SN1D; 0603
FB4, FB5: BLM21PG221SN1D; 0805-res
IC1: TPS7A0518PDBVT; SOT-23-5
IC2: TPS2378DDA; SOIC127P600X170-9N
J1: 5-2337992-8
J2: 46756-1001; HDMI_Micro-D_Molex_46765-1x01
J3, J4, J5, J11: 12401598E4_2A; USB-C_Female_12401X
J6: F52R-1A7H1-11020
J7: WE_68715014522
J8: DM3AT-SF-PEJM5; MicroSD_DM3AT-SF-PEJM5
J9: BM04B-SRSS-TB-LF-SN
J10: 1053131202; Molex_Nano-Fit_105313-xx02_1x02_P2.50mm_Horizontal
L1, L2, L3, L4, L5, L6: BRC1608TR35M; INDC1608X100N
L7, L8, L9, L10, L11, L12, L13, L14, L15, L16, L17, L18, L19, L20, L21, L22, L23, L24, L25: NFP0QHB242HS2D; FIL_NFP0QHB242HS2D
L26, L27, L28, L29: XEL4030-222MEC; Coilcraft-XEL4030
M1: SA800U-WF-mechanical_model; SA800U-WF_mechanical_model
M2: M2_2280; m2_2280
PS1: PDQE30-Q48-S5-D; PDQE30-Q48
Q1, Q2, Q3, Q4, Q5, Q6, Q7: BSS138APW; SC70-3
Q8, Q10, Q13, Q14: BSS84; SOT-23-3
Q9, Q11, Q12: Si7223DN; PowerPak-1212
Q15: BSS84PH6327XTSA2; SOT-23-3
Q16, Q17: SQS401EN-T1_BE3; Vishay_PowerPAK_1212-8_Single
R1, R2, R3, R4, R12, R16, R30, R31, R99, R145, R146, R151, R152, R162, R163, R164, R165: R_0R_0402; 0402-res
R5, R21, R118, R119, R120: R_1M0_0402; 0402-res
R6, R8, R17, R29, R41, R50, R77, R78, R79, R90, R91, R93, R111, R115, R116, R121, R122, R127, R128, R130, R131, R132, R133, R134, R138, R139, R142, R153: R_10k_0402; 0402-res
R7, R9, R15, R69, R73, R74, R75, R76, R95, R126, R159: R_1k_0402; 0402-res
R10: R_15k_0603; 0603-res
R11: R_2k49_1%_0402; 0402-res
R13, R14, R158: R_470R_0402; 0402-res
R18, R19, R20, R23, R24, R25, R26, R71, R72, R167, R168, R170, R172: R_4k7_0402; 0402-res
R22: R_7k68_0402; 0402-res
R27, R43, R136, R140: R_20k_0402; 0402-res
R28, R32, R62, R124, R125: R_2k2_0402; 0402-res
R33: R_27k_0402; 0402-res
R34, R36, R44, R46, R65, R66, R67, R68, R80, R81, R82, R83, R86, R87, R88, R89, R103, R104: R_2k_0402; 0402-res
R35, R37, R38, R39, R40, R42, R45, R47: R_50R_0402; 0402-res
R48, R49, R51, R52, R53, R54, R55, R56, R171: R_510R_0402; 0402-res
R57, R58, R60, R61, R63, R94, R147, R148, R154, R155, R156, R157, R160: R_100k_0402; 0402-res
R59: R_100k_0.5%_0402; 0402
R64, R105, R108, R112: R_200k_0402; 0402-res
R70: R_47k_0402; 0402-res
R84, R85: R_0R_0603; 0603-res
R92: R_220R_0402; 0402-res
R96, R97, R98, R100, R101, R102: R_33R_0402; 0402-res
R106, R109, R113: R_39k_0402; 0402-res
R107, R110, R114: R_13k7_0402; 0402-res
R117: R_255k_0402; 0402-res
R123: R_7k5_0402; 0402-res
R129: R_25k5_0402; 0402-res
R135: R_75k_0402; 0402-res
R137: R_31k6_0402; 0402-res
R141: R_52k3_0402; 0402-res
R143: R_24k9_0402; 0402-res
R144: R_63R4_0402; 0402-res
R149: R_20k_0603; 0603-res
R150: R_10k_0603; 0603-res
R161: R_22k_0402; 0402-res
R166: R_100R_0402; 0402-res
R169: R_1k1_0402; 0402-res
R173: R_750R_0402; 0402-res
R174: R_2k7_0402; 0402-res
S1, S2, S3, S4: KMR2; SW_SPST_4.2x2.8
SP1, SP2, SP3, SP4: 9774060151
SP5: 9774040151
TP1, TP2, TP3, TP4, TP5, TP6, TP7, TP8, TP9, TP10, TP11, TP12, TP13, TP14, TP15, TP16, TP17, TP18, TP19, TP20, TP21, TP22, TP23, TP24, TP25, TP26, TP28, TP29, TP30, TP31, TP32, TP33, TP34, TP35, TP36, TP37, TP38, TP39, TP40, TP41, TP42, TP43, TP44, TP45, TP46, TP47, TP48, TP49, TP50, TP51, TP52, TP53, TP54, TP55, TP57, TP59, TP60, TP64, TP65, TP66, TP67, TP69, TP86, TP87, TP88, TP89, TP90, TP91, TP92, TP93, TP94, TP95, TP96, TP97, TP99, TP100, TP101, TP102, TP103, TP104, TP105, TP106, TP107, TP108, TP109, TP110, TP111: TP_SMD_0_75MM; Testpoint_smd_0_75mm
TP27, TP56, TP58, TP61, TP62, TP63, TP68, TP70, TP71, TP72, TP73, TP74, TP75, TP76, TP77, TP78, TP79, TP80, TP81, TP82, TP83, TP84, TP85, TP98: TP; TP-R-1.5
U1: RTL8111H
U2, U8: TXB0104RUT; Texas_R_PUQFN-N12
U3: LT9611
U4, U10, U13, U14, U16: NTS0102GT; PSON50P100X195X50-8N
U5: FT232RQ-REEL; QFN-32-1EP_5x5mm
U6: TPS25820DSST; WSON-12_2x3mm
U7: NX3DV42GU; XQFN10-1.5x1.9mm
U9: CBTL02043ABQ,115; DHVQFN20
U11: SA800U-WF
U12: AP2114H-3_3TRG1; SOT-223
U15: MDT580M01001
U17: LTC4417IUF; LTC4417IUF-TRPBF
U18: LMV431IM5; SOT-23-5
U19, U20, U21, U22: AP62301WU-7; TSOT23-6
U23: STUSB4500QTR; QFN50P400X400X90-25N
Y1: ABM8G-25.000MHZ-18-D2Y-T; KX-7
Y2: ABM8G-24.000MHZ-18-D2Y-T; KX-7
kibuzzard-620E36F2, kibuzzard-620E3512, kibuzzard-620E3570, kibuzzard-620E3688, kibuzzard-620E3711, kibuzzard-620EAFC6, kibuzzard-620EAFCD, kibuzzard-620EAFD5, kibuzzard-620EAFE0, kibuzzard-620EB1D7, kibuzzard-620EB2A6, kibuzzard-620EB07A, kibuzzard-620EB19B, kibuzzard-620EB20E, kibuzzard-620EB24B, kibuzzard-620EB29C, kibuzzard-620EB068, kibuzzard-620EB071, kibuzzard-620EB074, kibuzzard-620EB293, kibuzzard-620EBDB4, kibuzzard-620F4F2B: G***; label

Connections:
1V2_SYS: C137.1, C140.1, L4.1, L5.1, L6.1, L28.2, R139.1, TP72.1
1V2_SYS_EN: R128.1, U11.2_132
1V8_DBG: C64.1, C75.1, IC1.5, TP101.1, U5.1
1V8_SYS: C63.1, U8.1, U8.12
3V3_SYS: C20.1, C54.1, C66.1, C72.1, C73.1, C74.1, C98.1, C111.1, C112.1, C113.1, C114.1, C120.1, C136.1, C139.1, D1.A, FB1.1, J6.20, J9.2, L1.1, L2.1, L3.1, L27.2, R9.1, R15.1, R17.1, R18.1, R19.1, R20.1, R25.1, R26.1, R29.1, R44.2, R46.2, R50.1, R57.2, R67.2, R68.2, R84.2, R90.1, R91.1, R92.1, R93.1, R103.2, R104.2, R137.1, TP71.1, U2.11, U4.7, U7.9, U9.1, U9.6, U9.10, U10.7, U15.2, U15.4, U15.12, U15.14, U15.16, U15.18, U15.70, U15.72, U15.74, U16.7
3V3_SYS_EN: R127.1, U11.2_134
3V8_SYS: C99.1, C100.1, C101.1, C102.1, C103.1, C104.1, C135.1, C141.1, D13.1, L26.2, R135.1, TP70.1, U11.1_159, U11.1_160, U11.1_161, U11.1_162, U11.1_163, U11.1_164, U11.1_165, U11.1_166, U11.1_167, U11.1_168
5V_POE: C147.1, C148.1, C149.1, C150.1, C151.1, PS1.4, Q12.7, Q12.8, R105.1, R151.2, TP50.1, TP84.1, U17.19
5V_SYS: C58.1, C59.1, C62.1, C65.1, C105.1, C130.1, C142.1, C143.1, D6.A, D14.1, D15.1, D16.1, FB2.1, J7.49, J7.50, L29.2, Q16.5, R28.1, R32.1, R60.2, R61.2, R63.2, R133.1, R141.1, R171.2, R173.1, TP28.1, TP63.1, TP73.1, U6.1, U6.2, U8.11, U12.3, U21.3
/Camera Interface/3V3_CAM: C109.1, C110.1, J7.47, J7.48, R84.1, R85.2, R86.2, R87.2, R88.2, R89.2, TP34.1, U13.7, U14.7
/Camera Interface/CCI0_I2C_SCL_3V3: J7.40, R87.1, TP36.1, U14.8
/Camera Interface/CCI0_I2C_SDA_3V3: J7.39, R89.1, TP38.1, U14.1
/Camera Interface/CCI1_I2C_SCL_3V3: J7.42, R86.1, TP35.1, U13.8
/Camera Interface/CCI1_I2C_SDA_3V3: J7.41, R88.1, TP37.1, U13.1
/Camera Interface/CSI0_CLK_FFC_N: J7.28, L25.3
/Camera Interface/CSI0_CLK_FFC_P: J7.29, L25.2
/Camera Interface/CSI0_LN0_FFC_N: J7.25, L24.3
/Camera Interface/CSI0_LN0_FFC_P: J7.26, L24.2
/Camera Interface/CSI0_LN1_FFC_N: J7.23, L23.3
/Camera Interface/CSI0_LN1_FFC_P: J7.24, L23.2
/Camera Interface/CSI0_LN2_FFC_N: J7.21, L22.3
/Camera Interface/CSI0_LN2_FFC_P: J7.22, L22.2
/Camera Interface/CSI0_LN3_FFC_N: J7.19, L21.3
/Camera Interface/CSI0_LN3_FFC_P: J7.20, L21.2
/Camera Interface/CSI1_CLK_FFC_N: J7.10, L20.3
/Camera Interface/CSI1_CLK_FFC_P: J7.11, L20.2
/Camera Interface/CSI1_LN0_FFC_N: J7.7, L19.3
/Camera Interface/CSI1_LN0_FFC_P: J7.8, L19.2
/Camera Interface/CSI1_LN1_FFC_N: J7.5, L18.3
/Camera Interface/CSI1_LN1_FFC_P: J7.6, L18.2
/Camera Interface/CSI1_LN2_FFC_N: J7.3, L17.3
/Camera Interface/CSI1_LN2_FFC_P: J7.4, L17.2
/Camera Interface/CSI1_LN3_FFC_N: J7.1, L16.3
/Camera Interface/CSI1_LN3_FFC_P: J7.2, L16.2
/Ethernet Controller/ETH_1V0: C12.1, C13.1, C14.1, C15.1, C17.1, R12.2, TP8.1, U1.3, U1.8, U1.22, U1.30
/Ethernet Controller/ETH_3V3: C3.1, C4.1, C5.1, C8.1, C9.1, C10.1, FB1.2, R13.2, R14.2, TP1.1, U1.11, U1.23, U1.32
/Ethernet Controller/ETH_ISOLATEB: R9.2, R10.1, TP3.1, U1.20
/Ethernet Controller/ETH_LED0: J1.18, U1.27
/Ethernet Controller/ETH_LED2: J1.16, U1.25
/Ethernet Controller/LAN0_MDI0_N: J1.1, U1.2
/Ethernet Controller/LAN0_MDI0_P: J1.2, U1.1
/Ethernet Controller/LAN0_MDI1_N: J1.3, U1.5
/Ethernet Controller/LAN0_MDI1_P: J1.6, U1.4
/Ethernet Controller/LAN0_MDI2_N: J1.7, U1.7
/Ethernet Controller/LAN0_MDI2_P: J1.8, U1.6
/Ethernet Controller/LAN0_MDI3_N: J1.9, U1.10
/Ethernet Controller/LAN0_MDI3_P: J1.10, U1.9
/Ethernet Controller/PCIE1_RX_C_N: C6.2, U1.18
/Ethernet Controller/PCIE1_RX_C_P: C7.2, U1.17
/Ethernet Controller/REG_1V0: C11.1, R12.1, TP7.1, U1.24
/Ethernet Controller/XTAL1: C1.1, R5.2, U1.28, Y1.1
/Ethernet Controller/XTAL2: C2.1, R5.1, U1.29, Y1.3
/HDMI converter/5V_HDMI: D2.K, J2.19, R41.1
/HDMI converter/5V_HDMI_FB_D: D2.A, FB2.2
/HDMI converter/HDMI_CEC: D3.4, D3.7, J2.15, Q3.3, R31.1, R33.2
/HDMI converter/HDMI_CLK_CONN_N: D4.5, D4.6, J2.14, L10.3
/HDMI converter/HDMI_CLK_CONN_P: D4.4, D4.7, J2.12, L10.2
/HDMI converter/HDMI_CLK_N: C49.1, C57.1, L10.4, R48.1
/HDMI converter/HDMI_CLK_P: C53.1, C56.1, L10.1, R49.1
/HDMI converter/HDMI_DETECT: D3.5, D3.6, J2.1, R30.2, R43.1, TP21.1
/HDMI converter/HDMI_SCL: D3.2, D3.9, J2.17, R28.2, TP16.1, U3.37
/HDMI converter/HDMI_SDA: D3.1, D3.10, J2.18, R32.2, TP19.1, U3.36
/HDMI converter/HDMI_TX0_CONN_N: D4.2, D4.9, J2.11, L9.3
/HDMI converter/HDMI_TX0_CONN_P: D4.1, D4.10, J2.9, L9.2
/HDMI converter/HDMI_TX0_N: C48.1, L9.4, R51.1
/HDMI converter/HDMI_TX0_P: C52.1, L9.1, R52.1
/HDMI converter/HDMI_TX1_CONN_N: D5.5, D5.6, J2.8, L8.3
/HDMI converter/HDMI_TX1_CONN_P: D5.4, D5.7, J2.6, L8.2
/HDMI converter/HDMI_TX1_N: C47.1, L8.4, R53.1
/HDMI converter/HDMI_TX1_P: C51.1, L8.1, R54.1
/HDMI converter/HDMI_TX2_CONN_N: D5.2, D5.9, J2.5, L7.3
/HDMI converter/HDMI_TX2_CONN_P: D5.1, D5.10, J2.3, L7.2
/HDMI converter/HDMI_TX2_N: C46.1, L7.4, R55.1
/HDMI converter/HDMI_TX2_P: C50.1, L7.1, R56.1
/HDMI converter/HDMI_TX_CLK_N: C49.2, R35.2, U3.38
/HDMI converter/HDMI_TX_CLK_P: C53.2, R37.2, U3.39
/HDMI converter/HDMI_TX_D0_N: C48.2, R38.2, U3.40
/HDMI converter/HDMI_TX_D0_P: C52.2, R39.2, U3.41
/HDMI converter/HDMI_TX_D1_N: C47.2, R40.2, U3.45
/HDMI converter/HDMI_TX_D1_P: C51.2, R42.2, U3.46
/HDMI converter/HDMI_TX_D2_N: C46.2, R45.2, U3.47
/HDMI converter/HDMI_TX_D2_P: C50.2, R47.2, U3.48
/HDMI converter/I2C_ADDR: R15.2, R16.1, TP9.1, U3.25
/HDMI converter/LT9611_CEC: Q3.2, R31.2, TP20.1, U3.24
/HDMI converter/LT9611_I2S_D0_SPDIF: U2.7, U3.30
/HDMI converter/LT9611_I2S_MCLK: U2.8, U3.29
/HDMI converter/LT9611_I2S_SCLK: U2.9, U3.28
/HDMI converter/LT9611_I2S_WS: U2.10, U3.27
/HDMI converter/LT9611_INTO_GPIO5: Q1.3, R20.2, R25.2, TP17.1, U3.23
/HDMI converter/LT9611_RST_N: C34.1, Q2.3, R17.2, R26.2, TP18.1, U3.17
/HDMI converter/LT9611_SCL: R19.2, R44.1, TP25.1, U3.18, U4.8
/HDMI converter/LT9611_SDA: R18.2, R46.1, TP26.1, U3.19, U4.1
/HDMI converter/LT9611_VCC12_RX: C24.1, C27.1, C30.1, L5.2, TP14.1, U3.4, U3.56
/HDMI converter/LT9611_VCC12_TX: C36.1, C39.1, L6.2, TP15.1, U3.44
/HDMI converter/LT9611_VCC33_IO: C23.1, C26.1, C29.1, C32.1, L1.2, TP10.1, U3.26, U3.34
/HDMI converter/LT9611_VCC33_RX: C38.1, C40.1, C41.1, C42.1, L2.2, TP12.1, U3.3, U3.51, U3.55
/HDMI converter/LT9611_VCC33_TX: C43.1, C45.1, L3.2, R35.1, R37.1, R38.1, R39.1, R40.1, R42.1, R45.1, R47.1, TP11.1, U3.43
/HDMI converter/LT9611_VDD12: C22.1, C25.1, C28.1, C31.1, C33.1, C35.1, C37.1, L4.2, TP13.1, U3.15, U3.16, U3.31, U3.53, U3.54
/HDMI converter/VCOM: C55.1, Q4.3, R48.2, R49.2, R51.2, R52.2, R53.2, R54.2, R55.2, R56.2, TP22.1, U3.42
/HDMI converter/XTALI: C21.1, R21.2, U3.49, Y2.3
/HDMI converter/XTALO: C19.1, R21.1, U3.50, Y2.1
/LCM/DSI_CLK_L_N: J6.14, L15.1
/LCM/DSI_CLK_L_P: J6.15, L15.4
/LCM/DSI_LN0_L_N: J6.11, L14.1
/LCM/DSI_LN0_L_P: J6.12, L14.4
/LCM/DSI_LN1_L_N: J6.8, L13.1
/LCM/DSI_LN1_L_P: J6.9, L13.4
/LCM/DSI_LN2_L_N: J6.5, L12.1
/LCM/DSI_LN2_L_P: J6.6, L12.4
/LCM/DSI_LN3_L_N: J6.2, L11.1
/LCM/DSI_LN3_L_P: J6.3, L11.4
/LCM/TP_I2C_SCL_3V3: J6.17, R67.1, U10.8
/LCM/TP_I2C_SDA_3V3: J6.18, R68.1, U10.1
/M2/C_PCIE0_TX0_N: C116.1, U15.47
/M2/C_PCIE0_TX0_P: C115.1, U15.49
/Other Interfaces/I2C10_SCL_3V3: J9.4, R103.1, TP46.1, U16.8
/Other Interfaces/I2C10_SDA_3V3: J9.3, R104.1, TP47.1, U16.1
/Other Interfaces/SD_CLK_R: D23.4, D23.7, J8.5, R100.2
/Other Interfaces/SD_CMD_R: D22.1, D22.10, J8.3, R98.2
/Other Interfaces/SD_DATA0_R: D23.2, D23.9, J8.7, R101.2
/Other Interfaces/SD_DATA1_R: D23.1, D23.10, J8.8, R102.2
/Other Interfaces/SD_DATA2_R: D22.4, D22.7, J8.1, R96.2
/Other Interfaces/SD_DATA3_R: D22.2, D22.9, J8.2, R97.2
/Other Interfaces/SD_DET_R: D22.5, D22.6, J8.10, R95.2
/Other Interfaces/SD_VDD_R: C118.1, C119.1, D23.5, D23.6, J8.4, R99.2
/PSU/5V_DC_DC_ENABLE: R129.2, R130.1, R134.2, TP69.1, U22.5
/PSU/AUX_VALID: Q8.1, R120.2, TP57.1, U17.7
/PSU/AUX_VDD: C121.1, C122.1, J10.1, Q9.7, Q9.8, R112.1, TP48.1, U17.21
/PSU/BYPASS_EN: Q14.1, Q15.2, Q16.4, R129.1, TP67.1
/PSU/POE_VALID: Q13.1, R118.2, TP54.1, U17.9
/PSU/USB_PD_VALID: Q10.1, R119.2, TP55.1, U17.8
/PSU/VS1: Q9.1, Q9.3, U17.18
/PSU/VS2: Q11.1, Q11.3, U17.16
/PSU/VS3: Q12.1, Q12.3, U17.14
/PoE/APD: IC2.8, R145.2
/PoE/CDB: IC2.6, R146.1
/PoE/CLS: IC2.3, R144.1
/PoE/DEN: IC2.2, R143.2
/PoE/SMPS_CTRL: PS1.1, R146.2, R147.2, R148.1, TP82.1
/PoE/TRIM: PS1.5, R151.1, R152.1, TP83.1
/PoE/VDD_POE: C144.1, C145.1, C146.1, D31.K, FB4.2, IC2.1, PS1.3, R143.1, R147.1, R149.1, TP78.1
/PoE/VSS_POE: C144.2, D31.A, FB5.2, IC2.4, IC2.9, R144.2, TP79.1
/SoM/BOOT: Q5.1, U11.2_136
/SoM/HOME_KEY_R: D17.1, R73.1, S1.2, S1.4
/SoM/PWR_R: D19.1, R75.1, S3.2, S3.4
/SoM/USER_LED: Q7.1, U11.2_2
/SoM/VOL_DOWN_R: D20.1, R76.1, S4.2, S4.4
/SoM/VOL_UP_R: D18.1, R74.1, S2.2, S2.4
/SoM/VRTC: BAT1.+, U11.2_133
/USB-C Interface /5V0_DBG: C69.1, C77.1, D6.K, FB3.2, IC1.1, IC1.3, TP111.1, U5.19
/USB-C Interface /DBG_USB_D_N: C68.2, D11.1, D11.10, J5.A7, J5.B7, U5.15
/USB-C Interface /DBG_USB_D_P: C70.2, D11.2, D11.9, J5.A6, J5.B6, U5.14
/USB-C Interface /DBG_VBUS: D11.4, D11.5, D11.6, D11.7, FB3.1, J5.A4, J5.A9, J5.B4, J5.B9
/USB-C Interface /USB1C_RX0_C_N: C87.2, D9.2, D9.9, J3.B10
/USB-C Interface /USB1C_RX0_C_P: C92.2, D9.1, D9.10, J3.B11
/USB-C Interface /USB1C_RX1_C_N: C84.1, D10.1, D10.10, J3.A10
/USB-C Interface /USB1C_RX1_C_P: C80.1, D10.2, D10.9, J3.A11
/USB-C Interface /USB1C_TX0_C_N: C79.1, D9.5, D9.6, J3.A3
/USB-C Interface /USB1C_TX0_C_P: C83.1, D9.4, D9.7, J3.A2
/USB-C Interface /USB1C_TX1_C_N: C93.2, D10.4, D10.7, J3.B3
/USB-C Interface /USB1C_TX1_C_P: C88.2, D10.5, D10.6, J3.B2
/USB-C Interface /USB1_SBU_N: D7.4, D7.7, J3.A8, U7.1
/USB-C Interface /USB1_SBU_P: D7.2, D7.9, J3.B8, U7.2
/USB-C Interface /USB2C_RX1_C_N: C90.1, J4.B10
/USB-C Interface /USB2C_RX1_C_P: C94.1, J4.B11
/USB-C Interface /USB2C_RX1_N: C90.2, U9.18
/USB-C Interface /USB2C_RX1_P: C94.2, U9.19
/USB-C Interface /USB2C_RX2_C_N: C86.1, J4.A10
/USB-C Interface /USB2C_RX2_C_P: C82.1, J4.A11
/USB-C Interface /USB2C_RX2_N: C86.2, U9.14
/USB-C Interface /USB2C_RX2_P: C82.2, U9.15
/USB-C Interface /USB2C_TX1_C_N: C81.1, J4.A3
/USB-C Interface /USB2C_TX1_C_P: C85.1, J4.A2
/USB-C Interface /USB2C_TX1_N: C81.2, U9.16
/USB-C Interface /USB2C_TX1_P: C85.2, U9.17
/USB-C Interface /USB2C_TX2_C_N: C95.1, J4.B3
/USB-C Interface /USB2C_TX2_C_P: C91.1, J4.B2
/USB-C Interface /USB2C_TX2_N: C95.2, U9.12
/USB-C Interface /USB2C_TX2_P: C91.2, U9.13
/USB-C Interface /USB2_5V: C71.1, C76.1, C78.1, J4.A4, J4.A9, J4.B4, J4.B9, U6.12
/USB-C Interface /USB2_CC1: J4.A5, U6.9
/USB-C Interface /USB2_CC2: J4.B5, U6.11
/USB-C Interface /USB2_CC_SELECT: R60.1, R64.1, TP110.1, U6.7, U9.9
/USB-C Interface /USB2_EN_5V: TP102.1, U6.4, U8.8
/USB-C Interface /USB2_FAULT_5V: R63.1, TP108.1, U6.5, U8.9
/USB-C Interface /USB2_SINK_5V: R61.1, TP109.1, U6.6, U8.10
/USB-C Interface /USB_SBU_NP_N: C61.2, R58.1, U7.5, U7.7
/USB-C Interface /USB_SBU_NP_P: C60.2, R57.1, U7.4, U7.6
/USB-PD/AB_SIDE: R163.2, R168.1, TP91.1, U23.17
/USB-PD/ALERT: R162.2, R167.1, TP89.1, U23.19
/USB-PD/ATTACH: R165.2, R172.1, TP96.1, U23.11
/USB-PD/GPIO: R164.2, R170.1, TP95.1, U23.15
/USB-PD/PD_CC1: D34.1, J11.A5, TP86.1, U23.1, U23.2
/USB-PD/PD_CC2: D33.1, J11.B5, TP87.1, U23.4, U23.5
/USB-PD/PD_VBUS: C152.1, D35.A, J11.A4, J11.A9, J11.B4, J11.B9, Q17.1, Q17.2, Q17.3, R158.1, R160.1
/USB-PD/STUSB4500_PWR_OK2: D36.1, TP93.1, U23.20
/USB-PD/STUSB4500_PWR_OK3: D36.3, TP94.1, U23.14
/USB-PD/STUSB_VDD: C157.1, TP97.1, U23.24
/USB-PD/VREG_1V2: C156.2, TP92.1, U23.21
/USB-PD/VREG_2V7: C154.1, R154.1, R155.1, TP90.1, U23.23
CAM0_PWDN: J7.32, TP40.1, U11.1_114
CAM0_RST: J7.33, TP39.1, U11.1_100
CAM1_PWDN: J7.34, TP41.1, U11.1_120
CCI0_I2C_SCL: R83.1, TP32.1, U11.1_142, U14.5
CCI0_I2C_SDA: R81.1, TP30.1, U11.1_144, U14.4
CCI1_I2C_SCL: R82.1, TP31.1, U11.1_148, U13.5
CCI1_I2C_SDA: R80.1, TP29.1, U11.1_146, U13.4
CSI0_CLK_N: L25.4, U11.1_30
CSI0_CLK_P: L25.1, U11.1_28
CSI0_LN0_N: L24.4, U11.1_22
CSI0_LN0_P: L24.1, U11.1_24
CSI0_LN1_N: L23.4, U11.1_16
CSI0_LN1_P: L23.1, U11.1_18
CSI0_LN2_N: L22.4, U11.1_10
CSI0_LN2_P: L22.1, U11.1_12
CSI0_LN3_N: L21.4, U11.1_6
CSI0_LN3_P: L21.1, U11.1_4
CSI1_CLK_N: L20.4, U11.1_58
CSI1_CLK_P: L20.1, U11.1_60
CSI1_LN0_N: L19.4, U11.1_52
CSI1_LN0_P: L19.1, U11.1_54
CSI1_LN1_N: L18.4, U11.1_46
CSI1_LN1_P: L18.1, U11.1_48
CSI1_LN2_N: L17.4, U11.1_42
CSI1_LN2_P: L17.1, U11.1_40
CSI1_LN3_N: L16.4, U11.1_34
CSI1_LN3_P: L16.1, U11.1_36
DBG_RXD: TP100.1, U5.30, U11.2_135
DBG_TXD: TP99.1, U5.2, U11.2_137
DSI0_CLK_N: L15.2, U11.2_26
DSI0_CLK_P: L15.3, U11.2_28
DSI0_LN0_N: L14.2, U11.2_38
DSI0_LN0_P: L14.3, U11.2_40
DSI0_LN1_N: L13.2, U11.2_32
DSI0_LN1_P: L13.3, U11.2_34
DSI0_LN2_N: L12.2, U11.2_20
DSI0_LN2_P: L12.3, U11.2_22
DSI0_LN3_N: L11.2, U11.2_14
DSI0_LN3_P: L11.3, U11.2_16
DSI1_CLK_N: U3.9, U11.2_21
DSI1_CLK_P: U3.10, U11.2_19
DSI1_LN0_N: U3.13, U11.2_13
DSI1_LN0_P: U3.14, U11.2_15
DSI1_LN1_N: U3.11, U11.2_37
DSI1_LN1_P: U3.12, U11.2_39
DSI1_LN2_N: U3.7, U11.2_27
DSI1_LN2_P: U3.8, U11.2_25
DSI1_LN3_N: U3.5, U11.2_31
DSI1_LN3_P: U3.6, U11.2_33
EDP_AUX_N: C61.1, U11.2_131
EDP_AUX_P: C60.1, U11.2_129
Earth: C16.2, J1.19, J1.20, R4.1
GND: BAT1.-, C1.2, C2.2, C3.2, C4.2, C5.2, C8.2, C9.2, C10.2, C11.2, C12.2, C13.2, C14.2, C15.2, C17.2, C18.1, C19.2, C20.2, C21.2, C22.2, C23.2, C24.2, C25.2, C26.2, C27.2, C28.2, C29.2, C30.2, C31.2, C32.2, C33.2, C34.2, C35.2, C36.2, C37.2, C38.2, C39.2, C40.2, C41.2, C42.2, C43.2, C44.2, C45.2, C54.2, C55.2, C56.2, C57.2, C58.2, C59.2, C62.2, C63.2, C64.2, C65.2, C66.2, C67.2, C68.1, C69.2, C70.1, C71.2, C72.2, C73.2, C74.2, C75.2, C76.2, C77.2, C78.2, C89.2, C96.2, C97.2, C98.2, C99.2, C100.2, C101.2, C102.2, C103.2, C104.2, C105.2, C106.2, C107.2, C108.2, C109.2, C110.2, C111.2, C112.2, C113.2, C114.2, C117.2, C118.2, C119.2, C120.2, C121.2, C122.2, C123.2, C124.2, C125.2, C126.2, C127.2, C128.2, C129.2, C130.2, C131.2, C135.2, C136.2, C137.2, C139.2, C140.2, C141.2, C142.2, C143.2, C147.2, C148.2, C149.2, C150.2, C151.2, C152.2, C153.2, C154.2, C156.1, C157.2, D3.3, D3.8, D4.3, D4.8, D5.3, D5.8, D7.3, D7.8, D8.3, D8.8, D9.3, D9.8, D10.3, D10.8, D11.3, D11.8, D12.3, D12.8, D13.2, D17.2, D18.2, D19.2, D20.2, D22.3, D22.8, D23.3, D23.8, D27.2, D33.2, D34.2, D36.2, D37.2, IC1.2, J2.4, J2.7, J2.10, J2.13, J2.16, J2.SH, J3.A1, J3.A12, J3.B1, J3.B12, J3.SH, J4.A1, J4.A12, J4.B1, J4.B12, J4.SH, J5.A1, J5.A12, J5.B1, J5.B12, J5.SH, J6.1, J6.4, J6.7, J6.10, J6.13, J6.16, J6.19, J7.9, J7.12, J7.15, J7.18, J7.27, J7.30, J8.6, J8.9, J8.11, J9.1, J10.2, J11.A1, J11.A12, J11.B1, J11.B12, J11.SH, PS1.6, Q4.2, Q5.2, Q6.2, Q7.2, Q8.2, Q10.2, Q13.2, Q14.2, R1.1, R2.1, R3.1, R10.2, R11.2, R16.2, R22.2, R27.2, R41.2, R43.2, R58.2, R59.2, R64.2, R69.2, R70.2, R107.2, R110.2, R114.2, R117.2, R124.2, R130.2, R136.1, R138.2, R140.1, R142.2, R152.2, R153.2, R156.2, R157.2, S1.1, S1.3, S2.1, S2.3, S3.1, S3.3, S4.1, S4.3, SP5.1, TP27.1, TP58.1, TP74.1, TP75.1, TP76.1, TP77.1, TP85.1, TP98.1, U1.33, U2.6, U3.65, U4.2, U5.4, U5.17, U5.20, U5.24, U5.26, U5.33, U6.3, U6.10, U6.13, U7.3, U8.6, U9.2, U9.5, U9.11, U9.20, U9.21, U10.2, U11.1_2, U11.1_7, U11.1_8, U11.1_13, U11.1_14, U11.1_19, U11.1_20, U11.1_25, U11.1_26, U11.1_31, U11.1_32, U11.1_37, U11.1_38, U11.1_41, U11.1_44, U11.1_50, U11.1_56, U11.1_59, U11.1_62, U11.1_65, U11.1_68, U11.1_71, U11.1_74, U11.1_77, U11.1_80, U11.1_83, U11.1_89, U11.1_93, U11.1_94, U11.1_97, U11.1_101, U11.1_105, U11.1_113, U11.1_119, U11.1_125, U11.1_131, U11.1_156, U11.1_157, U11.1_158, U11.2_11, U11.2_12, U11.2_17, U11.2_18, U11.2_23, U11.2_24, U11.2_29, U11.2_30, U11.2_35, U11.2_36, U11.2_41, U11.2_42, U11.2_45, U11.2_53, U11.2_98, U11.2_103, U11.2_104, U11.2_109, U11.2_110, U11.2_115, U11.2_116, U11.2_121, U11.2_122, U11.2_127, U11.2_155, U11.2_158, U11.2_161, U11.2_167, U12.1, U13.2, U14.2, U15.1, U15.3, U15.9, U15.15, U15.21, U15.27, U15.33, U15.39, U15.45, U15.51, U15.57, U15.71, U15.73, U15.75, U15.SH1, U15.SH2, U16.2, U17.10, U17.25, U18.5, U19.1, U20.1, U21.1, U22.1, U23.10, U23.22, U23.25, Y1.2, Y1.4, Y2.2, Y2.4
GNDD: C145.2, C146.2, D32.2, IC2.5, PS1.2, R145.1, R148.2, R150.2, TP81.1
HOME_KEY: R73.2, U11.2_145
I2C4_SCL: R36.1, TP24.1, U4.5, U11.2_6
I2C4_SDA: R34.1, TP23.1, U4.4, U11.2_4
I2C10_SCL: R72.1, TP45.1, U11.2_75, U16.5, U23.7
I2C10_SDA: R71.1, TP44.1, U11.2_77, U16.4, U23.8
I2S1_DATA0: U2.5, U11.2_87
I2S1_MCLK: U2.4, U11.2_81
I2S1_SCK: U2.3, U11.2_83
I2S1_WS: U2.2, U11.2_79
LT9611_GPIO5: Q1.2, R23.2, U11.2_68
LT9611_RST: Q2.2, R24.2, U11.2_70
LVS1A_1V8: C97.1, C106.1, C107.1, R65.2, R66.2, R80.2, R81.2, R82.2, R83.2, U10.3, U10.6, U11.1_149, U13.3, U13.6, U14.3, U14.6
M2_ALERT: R93.2, U15.44
unnamed: C16.1, J1.4, J1.5
unnamed: C67.1, U5.16
unnamed: C108.1, R85.1, TP33.1, U12.2, U12.4
unnamed: C123.1, Q9.2, Q9.4, TP51.1, U17.17
unnamed: C124.1, Q11.2, Q11.4, TP52.1, U17.15
unnamed: C125.1, Q12.2, Q12.4, TP53.1, U17.13
unnamed: C132.1, L26.1, U19.2
unnamed: C132.2, U19.6
unnamed: C133.1, L27.1, U20.2
unnamed: C133.2, U20.6
unnamed: C134.1, L28.1, U21.2
unnamed: C134.2, U21.6
unnamed: C138.1, U22.6
unnamed: C138.2, L29.1, U22.2
unnamed: C153.1, D35.K, R158.2, R159.1
unnamed: C155.2, R166.2
unnamed: D1.K, R33.1
unnamed: D7.1, D7.10
unnamed: D7.5, D7.6
unnamed: D12.4, D12.7
unnamed: D12.5, D12.6
unnamed: D14.2, R77.2
unnamed: D15.2, R78.2
unnamed: D16.2, R79.2
unnamed: D21.1, R92.2
unnamed: D21.2, U15.10
unnamed: D24.2, R111.2
unnamed: D25.2, R115.2
unnamed: D26.2, R116.2
unnamed: D27.1, R121.1
unnamed: D28.2, R122.2
unnamed: D29.1, D30.1, FB4.1
unnamed: D29.2, D30.2, FB5.1
unnamed: D32.1, R149.2, R150.1
unnamed: D36.4, R173.2
unnamed: D36.5, R174.2
unnamed: D36.6, R171.1
unnamed: IC2.7, TP80.1
unnamed: J1.15, R14.1
unnamed: J1.17, R13.1
unnamed: Q3.1, R29.2
unnamed: Q4.1, R50.2
unnamed: Q5.3, R77.1
unnamed: Q6.3, R78.1
unnamed: Q7.3, R79.1
unnamed: Q8.3, R111.1
unnamed: Q10.3, R115.1
unnamed: Q13.3, R116.1
unnamed: Q14.3, R122.1
unnamed: Q15.1, R126.2
unnamed: Q17.4, R160.2, R161.1, R166.1
unnamed: R1.2, SP1.1
unnamed: R2.2, SP2.1
unnamed: R3.2, SP3.1
unnamed: R4.2, SP4.1
unnamed: R11.1, TP6.1, U1.31
unnamed: R22.1, U3.52
unnamed: R27.1, R30.1, U3.35
unnamed: R59.1, U6.8
unnamed: R69.1, U11.1_134
unnamed: R70.1, U11.2_143
unnamed: R105.2, R106.1, U17.5
unnamed: R106.2, R107.1, U17.6
unnamed: R108.2, R109.1, U17.3
unnamed: R109.2, R110.1, U17.4
unnamed: R112.2, R113.1, U17.1
unnamed: R113.2, R114.1, U17.2
unnamed: R117.1, U17.24
unnamed: R123.2, R124.1, TP59.1, U18.4
unnamed: R125.2, R126.1, TP60.1, U18.3
unnamed: R127.2, R132.2, TP65.1, U20.5
unnamed: R128.2, R133.2, TP66.1, U21.5
unnamed: R131.2, TP64.1, U19.5
unnamed: R135.2, R136.2, U19.4
unnamed: R137.2, R138.1, U20.4
unnamed: R139.2, R140.2, U21.4
unnamed: R141.2, R142.1, U22.4
unnamed: R154.2, R156.1, U23.12
unnamed: R155.2, R157.1, U23.13
unnamed: R159.2, U23.18
unnamed: R161.2, U23.16
unnamed: R169.2, U23.9
unnamed: TP42.1, U15.42
unnamed: TP43.1, U15.40
PAIR12: D29.4, J1.11
PAIR36: D29.3, J1.12
PAIR45: D30.4, J1.13
PAIR78: D30.3, J1.14
PCIE0_CLKREQ_N: R91.2, U11.1_5, U15.50
PCIE0_REFCLK_N: U11.1_17, U15.53
PCIE0_REFCLK_P: U11.1_15, U15.55
PCIE0_RST_N: U11.1_1, U15.54
PCIE0_RX_N: U11.1_23, U15.41
PCIE0_RX_P: U11.1_21, U15.43
PCIE0_TX_N: C116.2, U11.1_9
PCIE0_TX_P: C115.2, U11.1_11
PCIE0_WAKE_N: R90.2, U11.1_3, U15.52
PCIE1_CLKREQ_N: R6.2, TP2.1, U1.12, U11.1_109
PCIE1_REFCLK_N: U1.16, U11.1_123
PCIE1_REFCLK_P: U1.15, U11.1_121
PCIE1_RST_N: R8.2, TP5.1, U1.19, U11.1_107
PCIE1_RX_N: C6.1, U11.1_117
PCIE1_RX_P: C7.1, U11.1_115
PCIE1_TX_N: U1.14, U11.1_127
PCIE1_TX_P: U1.13, U11.1_129
PCIE1_WAKE_N: R7.2, TP4.1, U1.21, U11.1_111
PD_VDD: C155.1, D37.1, Q11.7, Q11.8, Q17.5, R108.1, R169.1, R174.1, TP49.1, U17.20
PWRKEY: R75.2, U11.2_5
SBU_SW_OE: R62.1, TP103.1, U7.8, U11.2_1
SBU_SW_SEL: TP104.1, U7.10, U11.2_3
SD_CLK: R100.1, U11.1_45
SD_CMD: R98.1, U11.1_47
SD_DATA0: R101.1, U11.1_51
SD_DATA1: R102.1, U11.1_53
SD_DATA2: R96.1, U11.1_57
SD_DATA3: R97.1, U11.1_55
SD_DET: R94.2, R95.1, U11.1_49
SD_LDO21A: R99.1, U11.1_151, U11.1_153, U11.1_155
STUSB4500_AB_SIDE: R163.1, U11.2_66
STUSB4500_ALERT: R162.1, U11.2_64
STUSB4500_ATTACH: R165.1, U11.2_74
STUSB4500_GPIO: R164.1, U11.2_72
TP_I2C_SCL: R66.1, U10.5, U11.2_44
TP_I2C_SDA: R65.1, U10.4, U11.2_46
USB1_D_N: D8.2, D8.9, J3.A7, J3.B7, U11.2_117
USB1_D_P: D8.4, D8.7, J3.A6, J3.B6, U11.2_119
USB1_SS_RX0_N: C87.1, U11.2_118
USB1_SS_RX0_P: C92.1, U11.2_120
USB1_SS_RX1_N: C84.2, U11.2_114
USB1_SS_RX1_P: C80.2, U11.2_112
USB1_SS_TX0_N: C79.2, U11.2_123
USB1_SS_TX0_P: C83.2, U11.2_125
USB1_SS_TX1_N: C93.1, U11.2_111
USB1_SS_TX1_P: C88.1, U11.2_113
USB2C_HS_D_N: D12.1, D12.10, J4.A7, J4.B7, U11.2_107
USB2C_HS_D_P: D12.2, D12.9, J4.A6, J4.B6, U11.2_105
USB2_EN: TP107.1, U8.4, U11.2_54
USB2_FAULT: TP106.1, U8.3, U11.1_118
USB2_SINK: TP105.1, U8.2, U11.2_80
USB2_SS_RX_N: U9.4, U11.2_100
USB2_SS_RX_P: U9.3, U11.2_102
USB2_SS_TX_N: U9.8, U11.2_108
USB2_SS_TX_P: U9.7, U11.2_106
USB_CC1: D8.5, D8.6, J3.A5, U11.2_141
USB_CC2: D8.1, D8.10, J3.B5, U11.2_139
USB_PD_DISABLE: R153.1, TP88.1, U11.2_76, U23.6
USB_VBUS: C89.1, C96.1, J3.A4, J3.A9, J3.B4, J3.B9, U11.2_160, U11.2_162, U11.2_164, U11.2_166, U11.2_168
VDD: C126.1, C127.1, C128.1, C129.1, C131.1, D24.1, D25.1, D26.1, D28.1, Q9.5, Q9.6, Q11.5, Q11.6, Q12.5, Q12.6, Q15.3, Q16.1, Q16.2, Q16.3, R118.1, R119.1, R120.1, R121.2, R123.1, R125.1, R131.1, R132.1, R134.1, TP56.1, TP61.1, TP62.1, TP68.1, U17.12, U19.3, U20.3, U22.3
VOL_DOWN: R76.2, U11.2_7
VOL_UP: R74.2, U11.2_9
VREG_S4A_1V8: C18.2, C44.1, C117.1, Q1.1, Q2.1, Q6.1, R6.1, R7.1, R8.1, R23.1, R24.1, R34.2, R36.2, R62.2, R71.2, R72.2, R94.1, R167.2, R168.2, R170.2, R172.2, U2.1, U2.12, U4.3, U4.6, U11.2_124, U11.2_126, U11.2_128, U16.3, U16.6
