antmicro/snapdragon-845-baseboard/(commit log)

2022-03-28 created a kicad proj structure
    [sa800u-baseboard-hw.kicad_pcb, sa800u-baseboard-hw.sch]
2022-03-28 provided documentation
    [Quectel_SA800U-WF_3D_Dimensions_Revision_History.xlsx, Quectel_SA800U-WF_Footprint&Part_Revision_History.xlsx, Quectel_SA800U-WF_PCB_Footprint_AD_V1.1.PcbDoc, Quectel_SA800U-WF_PCB_Footprint_Cadence_V1.1.brd, Quectel_SA800U-WF_PCB_Footprint_PADS_V1.1.pcb, Quectel_SA800U-WF_Pin_Description_and_GPIO_Configuration_V1.0.xlsx, Quectel_SA800U-WF_Pin_Description_and_GPIO_Configuration_V1.1.xlsx, Quectel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]
2022-03-28 added J3 and J4 connectors
2022-03-28 added initial version of PoE
    [PoE.sch, sa800u-baseboard-hw.sch]
2022-03-28 added initial version of ethernet controller
    [Ethernet Controller.sch, PoE.sch, sa800u-baseboard-hw.sch]
2022-03-28 added a voltage trimming possibility in PoE circuit
    [Ethernet Controller.sch, PoE.sch]
2022-03-28 added ethernet oscillator and some controll pins
    [Ethernet Controller.sch, HDMI.sch, PoE.sch, sa800u-baseboard-hw.sch]
2022-03-28 added annotations
    [Ethernet Controller.sch]
2022-03-28 added display port switch
    [Ethernet Controller.sch, PoE.sch, USB-C Interface .sch, sa800u-baseboard-hw.sch]
2022-03-28 added usb type - c connector
    [USB-C Interface .sch]
2022-03-28 added 2 DSI connectors
    [Ethernet Controller.sch, HDMI.sch, LCM.sch, PoE.sch, USB-C Interface .sch, sa800u-baseboard-hw.sch]
2022-03-28 added chokes on datalines
    [LCM.sch]
2022-03-28 added HDMI converter
    [HDMI.sch, LCM.sch]
2022-03-28 fixed labels in HDMI converter
    [Ethernet Controller.sch, HDMI_converter.sch, LCM.sch, Level_shift_HDMI.sch, PoE.sch, USB-C Interface .sch, sa800u-baseboard-hw.sch]
2022-03-28 added level shifters for I2S, reset, I2C, and GPIO
    [HDMI_converter.sch, Level_shift_HDMI.sch]
2022-03-28 Review - Add geeral remarks
    [Ethernet Controller.sch, HDMI_converter.sch, LCM.sch, Level_shift_HDMI.sch, PoE.sch, USB-C Interface .sch, sa800u-baseboard-hw.sch]
2022-03-28 fixed doubled pullups for I2C in DSI, changed connectors antmicro lib connectors
    [Ethernet Controller.sch, LCM.sch]
2022-03-28 fixed ethernet controller symbol
    [Ethernet Controller.sch, PoE.sch]
2022-03-28 fixed labels for differential pairs
    [Ethernet Controller.sch, USB-C Interface .sch]
2022-03-28 fixed part of labels
    [Ethernet Controller.sch]
2022-03-28 introducing minor genreal improvements
    [Ethernet Controller.sch, HDMI_converter.sch, Level_shift_HDMI.sch, PoE.sch, USB-C Interface .sch]
2022-03-28 fixed / unified power labels
    [Ethernet Controller.sch, HDMI_converter.sch, PoE.sch, USB-C Interface .sch]
2022-03-28 flattenning directory
    [Ethernet Controller.sch, USB-C Interface .sch, sa800u-baseboard-hw.sch]
2022-03-28 fixed (flattenned) directory structure
    [Ethernet Controller.sch, HDMI.sch, HDMI_converter.sch, LCM.sch, Level_shift_HDMI.sch, PoE.sch, USB-C Interface .sch, sa800u-baseboard-hw.kicad_pcb]
2022-03-28 fixing directory
    [Ethernet Controller.sch, HDMI_converter.sch, LCM.sch, Level_shift_HDMI.sch, PoE.sch, USB-C Interface .sch, sa800u-baseboard-hw.sch]
2022-03-28 changed sheets format to A3
    [HDMI_converter.sch, LCM.sch, Level_shift_HDMI.sch, PoE.sch, USB-C Interface .sch, sa800u-baseboard-hw.sch]
2022-03-28 fixed files names
    [Ethernet_Controller.sch, USB-C_Interface.sch, sa800u-baseboard-hw.sch]
2022-03-28 removed redundatn files
    [Ethernet Controller.sch, USB-C Interface .sch]
2022-03-28 removed finished remarks
    [Ethernet_Controller.sch, Level_shift_HDMI.sch, sa800u-baseboard-hw.sch]
2022-03-28 finished level shifting circuits for HDMI
    [Ethernet_Controller.sch, HDMI_converter.sch, LCM.sch, Level_shift_HDMI.sch, PoE.sch, SoM.sch, USB-C_Interface.sch, sa800u-baseboard-hw.sch]
2022-03-28 added Cameras interface and finished SoM model and symbol
    [Cameras_Interface.sch, Ethernet_Controller.sch, HDMI_converter.sch, LCM.sch, Level_shift_HDMI.sch, PoE.sch, SoM.sch, USB-C_Interface.sch]
2022-03-28 work in progress, added usb hub, connectors, and m2 connector
    [HDMI_converter.sch, Level_shift_HDMI.sch, M2.sch, SoM.sch, USB-C_Interface.sch, sa800u-baseboard-hw.sch]
2022-03-28 added sd card, buttons, rtc battery - work in progress
    [Cameras_Interface.sch, Ethernet_Controller.sch, HDMI_converter.sch, LCM.sch, M2.sch, Other_Interfaces.sch, PoE.sch, SoM.sch]
2022-03-28 added some usb connectors, goldpins for GPIO and I2C, fixed buttons
    [Other_Interfaces.sch, SoM.sch, USB-C_Interface.sch]
2022-03-28 added components to pcb and fixed corresponding errors
    [Cameras_Interface.sch, Ethernet_Controller.sch, HDMI_converter.sch, LCM.sch, M2.sch, Other_Interfaces.sch, PoE.sch, SoM.sch]
2022-03-28 added first version of board layout
    [Cameras_Interface.sch, Ethernet_Controller.sch, HDMI_converter.sch, LCM.sch, M2.sch, Other_Interfaces.sch, PSU.sch, PoE.sch]
2022-03-28 2nd version of board layout
    [sa800u-baseboard-hw.kicad_pcb]
2022-03-28 changed rtc battery to smaller model
    [SoM.sch, sa800u-baseboard-hw.kicad_pcb]
2022-03-28 permanently added mounting holes
    [sa800u-baseboard-hw.kicad_pcb, sa800u-baseboard-hw.sch]
2022-03-28 added holes on schematic
    [sa800u-baseboard-hw.sch]
2022-03-28 replaced common mode chokes, dedicated for hdmi and with smaller footprint
    [Cameras_Interface.sch, LCM.sch, sa800u-baseboard-hw.kicad_pcb]
2022-03-28 modified layout of the board so that ethernet is further away from poe psu
    [Cameras_Interface.sch, sa800u-baseboard-hw.kicad_pcb]
2022-03-28 minor fixes
    [PoE.sch, sa800u-baseboard-hw.kicad_pcb]
2022-03-28 added an initial version of SoM
    [Other_Interfaces.sch, SoM.sch]
2022-03-28 re-evaluated gpios
    [SoM.sch]
2022-03-28 finished gpios
    [SoM.sch]
2022-03-28 fixed TVS diodes for buttons and USB
    [SoM.sch, USB-C_Interface.sch]
2022-03-28 changed tvs diodes to ones with smaller wpr voltage and in array
    [HDMI_converter.sch, SoM.sch]
2022-03-28 created initial version of HDMI out connector
    [HDMI_converter.sch]
2022-03-28 connect USB hub - work in progress
    [SoM.sch, USB-C_Interface.sch]
2022-03-28 finished implementing usb hub
    [USB-C_Interface.sch]
2022-03-28 fix to naming convention of differential pairs
    [USB-C_Interface.sch]
2022-03-28 implemented usb - c connectors
    [USB-C_Interface.sch]
2022-03-28 implementing usb muxes and current limiter
    [Cameras_Interface.sch, Ethernet_Controller.sch, HDMI_converter.sch, LCM.sch, M2.sch, Other_Interfaces.sch, PSU.sch, PoE.sch]
2022-03-28 added usb c controller and mux, removed hub
    [Cameras_Interface.sch, Ethernet_Controller.sch, HDMI_converter.sch, LCM.sch, M2.sch, Other_Interfaces.sch, PSU.sch, PoE.sch]
2022-03-28 cleaning repo from unused schematics usb hub and usb interfaces
    [USB_Connectors.sch, USB_Hub.sch]
2022-03-28 changed arrangement of hierarchical sheets
    [Ethernet_Controller.sch, HDMI_converter.sch, LCM.sch, SoM.sch, USB-C_Interface.sch, sa800u-baseboard-hw.sch]
2022-03-28 cleaned up components fields
    [Cameras_Interface.sch, HDMI_converter.sch, LCM.sch, PoE.sch]
2022-03-28 added chokes and decoupling caps in hdmi power rails and ethernet power rails
    [Ethernet_Controller.sch, HDMI_converter.sch, M2.sch, Other_Interfaces.sch, PSU.sch, SoM.sch]
2022-03-28 Add review comments
    [Ethernet_Controller.sch, PoE.sch, sa800u-baseboard-hw.sch]
2022-03-28 cleaned up and added descriptions to usb sheet
    [USB-C_Interface.sch]
2022-03-28 add decoupling capacitors and tvs to som
    [SoM.sch]
2022-03-28 add necessary decoupling capacitors
    [Cameras_Interface.sch, USB-C_Interface.sch]
2022-03-28 fixed clock connections
    [Ethernet_Controller.sch, HDMI_converter.sch]
2022-03-28 fixed mismatched clock freq
    [HDMI_converter.sch]
2022-03-28 added current limiting transistor circuit for poe controller
    [PoE.sch]
2022-03-28 removed transistor circtuit - work in progress
    [PoE.sch]
2022-03-28 added 7k5 resistor between rtn and vdd, removed transistor circuit, add descriptions
    [PoE.sch]
2022-03-28 changed converter AP62301WU-7 to the same one but with bigger footprint
    [PSU.sch]
2022-03-28 added auxiliary power connector
    [PSU.sch]
2022-03-28 added bulk 2 more capacitors to som
    [SoM.sch]
2022-03-28 changed naming convention for main powerline
    [PoE.sch]
2022-03-28 add 5V psu logic
    [PoE.sch]
2022-03-28 Add local libs to fix CI
    [Cameras_Interface.sch, Ethernet_Controller.sch, HDMI.sch, HDMI_converter.sch, LCM.sch, Level_shift_HDMI.sch, M2.sch, Other_Interfaces.sch]
2022-03-28 removed unused temorary USB PD lib
    [PSU.sch]
2022-03-28 fixed voltage divider to allow smaller current for LMV431 and added description
    [PSU.sch]
2022-03-28 finished initial version of 5V PSU
    [PSU.sch]
2022-03-28 changed mounting holes to spacers
    [sa800u-baseboard-hw.sch]
2022-03-28 minor changes
    [PSU.sch, PoE.sch]
2022-03-28 add rj45 without trafo
    [Ethernet_Controller.sch]
2022-03-28 finished rebuilding ethernet connector
    [Ethernet_Controller.sch]
2022-03-28 added reference to chineese replacement of RJ45
    [Ethernet_Controller.sch]
2022-03-28 add temp psu sheet
    [Cameras_Interface.sch, Ethernet_Controller.sch, HDMI_converter.sch, LCM.sch, M2.sch, Other_Interfaces.sch, PSU.sch, PoE.sch]
2022-03-28 add 1V8 converter
    [Temp_psu.sch]
2022-03-28 change 3.075V from top conn to regular 3V3
    [USB-C_Interface.sch]
2022-03-28 fixing ERC errors
    [Ethernet_Controller.sch, HDMI_converter.sch, LCM.sch, SoM.sch, Temp_psu.sch, USB-C_Interface.sch]
2022-03-28 Add comment about BGA package
    [Cameras_Interface.sch]
2022-03-28 Add comment about resistor and capacitors
    [Ethernet_Controller.sch]
2022-03-28 Add comment about parts packages and OE controll
    [HDMI_converter.sch]
2022-03-28 Add comment about 7k5 resistors package
    [PoE.sch]
2022-03-28 Change inductor to smaller size, add comment on fet
    [PSU.sch]
2022-03-28 Populate DCDCs with passives
    [Temp_psu.sch]
2022-03-28 Add note on packages and missmatch on pin names
    [USB-C_Interface.sch]
2022-03-28 Add comment on 3D models
    [SoM.sch]
2022-03-28 Import changes to PCB, group components
    [sa800u-baseboard-hw.kicad_pcb]
2022-03-28 add USB - PD circuit work in progress
    [USB-PD.sch]
2022-03-28 add USB-PD sheet
    [Cameras_Interface.sch, Ethernet_Controller.sch, HDMI_converter.sch, LCM.sch, M2.sch, Other_Interfaces.sch, PSU.sch, PoE.sch]
2022-03-28 Add uSD circuitry
    [Other_Interfaces.sch]
2022-03-28 Grpuing new parts
    [sa800u-baseboard-hw.kicad_pcb]
2022-03-28 Populate M2.sch
    [M2.sch]
2022-03-28 Annotate parts in Other_Interfaces.sch
    [Other_Interfaces.sch]
2022-03-28 Change in/out parameter of PCIE0 labels
    [SoM.sch]
2022-03-28 implementing USB PD - work in progress
    [USB-PD.sch]
2022-03-28 Connect uSD to SOM
    [Other_Interfaces.sch]
2022-03-28 Add USB debug circuitry, loclib
    [Ethernet_Controller.sch, HDMI_converter.sch, M2.sch, Other_Interfaces.sch, PSU.sch, SoM.sch, Temp_psu.sch, USB-C_Interface.sch]
2022-03-28 Change FTFI symbol to simplify schematic
    [USB-C_Interface.sch]
2022-03-28 Anotate parts
    [USB-C_Interface.sch, USB-PD.sch]
2022-03-28 Update SD circuitry to match ref design
    [Other_Interfaces.sch]
2022-03-28 Annotate parts
    [Other_Interfaces.sch]
2022-03-28 Move parts from tmp to PSU.sch
    [PSU.sch, Temp_psu.sch]
2022-03-28 Remove Temp_psu.sch
    [Temp_psu.sch]
2022-03-28 Remove tmp sheet from main schematic sheet
    [sa800u-baseboard-hw.sch]
2022-03-28 add output TVS diode supplement ESD144B1W0201E6327XTSA1
    [USB-PD.sch]
2022-03-28 add I2C address selection circuit
    [USB-PD.sch]
2022-03-28 add i2c pullups
    [USB-PD.sch]
2022-03-28 add OD signaling pins with pullups network
    [USB-PD.sch]
2022-03-28 finished USB-PD
    [USB-PD.sch]
2022-03-28 Update symbol of SA800U, split naming of power rails, fix label directions
    [SoM.sch]
2022-03-28 Add coments to SA800U interfaces
    [SoM.sch]
2022-03-28 Add missing power flags, minor changes in comments
    [SoM.sch]
2022-03-28 Cleanup LCM, add voltage translator to LCM I2C
    [LCM.sch]
2022-03-28 Update number of schematics sheets
    [Cameras_Interface.sch, Ethernet_Controller.sch, HDMI_converter.sch, M2.sch, Other_Interfaces.sch, PSU.sch, PoE.sch, USB-C_Interface.sch]
2022-03-28 Change 30pin connector to 15 pin one
    [LCM.sch]
2022-03-28 Cleanup PoE.sch, change names of power lines
    [PSU.sch, PoE.sch]
2022-03-28 Cleanign Ethernet_Controller.sch
    [Ethernet_Controller.sch]
2022-03-28 Fix C8 and C7 ref positions
    [Ethernet_Controller.sch]
2022-03-28 Change I2C voltage translator for smaller bom
    [Cameras_Interface.sch]
2022-03-28 Add 1uF cap for every pair of 3V3 pads in M.2, remove 100nF cap
    [M2.sch]
2022-03-28 Update power labels
    [PSU.sch]
2022-03-28 Add comments
    [PoE.sch]
2022-03-28 Cleanup USB-PD.sch, tweak STUSB and RGB led symbols for cleaner schematic
    [USB-PD.sch]
2022-03-28 Update Ethernet_Controller.sch, tweak RTL8111H for simpler schematic
    [Ethernet_Controller.sch]
2022-03-28 Cleanup HDMI_converter.sch. Tweak symbols, change transistors and voltage translators
    [HDMI_converter.sch]
2022-03-28 add initial version of power management circuit
    [PSU.sch]
2022-03-28 Fix VCOM labels
    [HDMI_converter.sch]
2022-03-28 Fix naming in power labels
    [PSU.sch, PoE.sch]
2022-03-28 Update DCDC input labels, update symbols of Si7223DN to simplify schematic
    [PSU.sch]
2022-03-28 Update power labels in HDMI sch, change VCOM transistor to smd, add filtering to 5V HDMI, change 510R res size to 0402
    [HDMI_converter.sch]
2022-03-28 Add ferrite bead to 3V3 path to ethernet, update power labels
    [Ethernet_Controller.sch]
2022-03-28 Set C19 to DNP, make DNP visible. Remove C18
    [Ethernet_Controller.sch]
2022-03-28 Update C19 fields
    [Ethernet_Controller.sch]
2022-03-28 Update power labels in USB2 seciton of USB sch, reorganize USB2 section
    [USB-C_Interface.sch]
2022-03-28 Change U7 OE voltage to 1V8, change USB2.0 TSV to TPD4E05U06 to consolidate bom
    [USB-C_Interface.sch]
2022-03-28 Remove junction between USB1_SS_RX1_N and USB_VBUS
    [USB-C_Interface.sch]
2022-03-28 Update USB1 connector circuitry to match USB2, make it more readable
    [USB-C_Interface.sch]
2022-03-28 Update TSV diode on USB1, add second for VBUS and SBU signals
    [USB-C_Interface.sch]
2022-03-28 Change USB switch, loclib
    [USB-C_Interface.sch]
2022-03-28 Update FUSB30MUX symbol to clarify muxing
    [USB-C_Interface.sch]
2022-03-28 Change bypass transistor package, clean PSU sheet
    [PSU.sch]
2022-03-28 Update comments on power supplies
    [SoM.sch]
2022-03-28 Change SBU pullup voltage to 3V3_SYS
    [USB-C_Interface.sch]
2022-03-28 Add power distribution diagram
    [Cameras_Interface.sch, Ethernet_Controller.sch, HDMI_converter.sch, LCM.sch, M2.sch, Other_Interfaces.sch, PSU.sch, PoE.sch]
2022-03-28 Change LT9611_VCC12* and LT9611_VCC33* to local, change 3V3 to 3V3_sys on R59
    [HDMI_converter.sch]
2022-03-28 Remove broken symbols of 510R resistors, add new ones
    [HDMI_converter.sch]
2022-03-28 Change 3V to 3V3_SYS on R102
    [M2.sch]
2022-03-28 Change spacers to 6mm
    [sa800u-baseboard-hw.sch]
2022-03-28 Change SD_DET pullup voltage source. Improve readability
    [Other_Interfaces.sch]
2022-03-28 Change 1V8 DCDC to 3V8 VBAT generator
    [PSU.sch]
2022-03-28 Change LTC4417 resistor values, add indicator leds, update power labels
    [PSU.sch, SoM.sch]
2022-03-28 Change comment on CDB
    [PoE.sch]
2022-03-28 Update power label
    [Cameras_Interface.sch]
2022-03-28 Remove zener diode, annotate parts
    [PoE.sch]
2022-03-28 Add 1k to CBL_PWR_N for automatic boot
    [SoM.sch]
2022-03-28 Add 3V3 LDO for camera alternative supply
    [Cameras_Interface.sch]
2022-03-28 Remove ferrite bead and 47uF capacitor
    [PoE.sch]
2022-03-28 Add option to controll 1V2 and 3V3 DCDC converters
    [SoM.sch]
2022-03-28 Annotate parts, add 3D model of USB-C plug, update PCB
    [sa800u-baseboard-hw.kicad_pcb, sa800u-baseboard-hw.sch]
2022-03-28 Add additional load to VDD_POE
    [PoE.sch]
2022-03-28 Change microSD card holder
    [Other_Interfaces.sch]
2022-03-28 Minor change
    [PSU.sch]
2022-03-28 Loclib, add 3D models of plugs
    [sa800u-baseboard-hw.kicad_pcb]
2022-03-28 Mockup of the connectors placement. Add nvme 3d model
    [M2.sch, sa800u-baseboard-hw.kicad_pcb]
2022-03-28 Fix typo in label
    [HDMI_converter.sch]
2022-03-28 Change p-mosfet to smaller package
    [USB-PD.sch]
2022-03-28 Restore pcb with grouped parts. Change C33 to DNP
    [HDMI_converter.sch, sa800u-baseboard-hw.kicad_pcb]
2022-03-28 Update 510R resistors
    [HDMI_converter.sch]
2022-03-28 Update PCB witch changes, continue placement
    [sa800u-baseboard-hw.kicad_pcb]
2022-03-28 Add names to nets connected to HDMI connector
    [HDMI_converter.sch]
2022-03-28 Minor change to make HDMI conn connections more readable
    [HDMI_converter.sch]
2022-03-28 Change U7 to smaller package
    [USB-C_Interface.sch]
2022-03-28 Remove items that are outside of the PCB for presentation
    [sa800u-baseboard-hw.kicad_pcb]
2022-03-28 Fix names of HDMI nets, add TSV - connection TBD
    [HDMI_converter.sch]
2022-03-28 Update PCB with recent changes, continue work on LT9611
    [sa800u-baseboard-hw.kicad_pcb]
2022-03-28 Change USB connectors to E8124-015-01, change TSVs to PUSB3F96X_PASS
    [HDMI_converter.sch, USB-C_Interface.sch, USB-PD.sch]
2022-03-28 Fix labels
    [HDMI_converter.sch]
2022-03-28 Connect cathode of indicator leds to output of LTC4417IUF
    [PSU.sch]
2022-03-28 Change ESD module
    [USB-PD.sch]
2022-03-28 Update powerPack-1212 footprint
2022-03-28 Continue placement
    [sa800u-baseboard-hw.kicad_pcb]
2022-03-28 Add net labels between capacitors and eth connector
    [Ethernet_Controller.sch]
2022-03-28 Update power label on SoM 3V8 (VBAT) capacitors
    [SoM.sch]
2022-03-28 Update power label on D15
    [SoM.sch]
2022-03-28 Overall placement of all parts
    [sa800u-baseboard-hw.kicad_pcb]
2022-03-28 Add labels
    [sa800u-baseboard-hw.kicad_pcb]
2022-03-28 Add GND pour under SA800U module
    [sa800u-baseboard-hw.kicad_pcb]
2022-03-28 Cleanup project
    [HDMI.sch, Level_shift_HDMI.sch, ZBH0096A.stp]
2022-03-28 Unify naming
    [camera-interface.sch, ethernet-controller.sch, hdmi-converter.sch, lcm.sch, m2.sch, other-interfaces.sch, poe.sch, power-distribution-diagram.sch]
2022-03-28 Change USB-C connectors, continue layout
    [psu.sch, sa800u-baseboard-hw.kicad_pcb, usb-c-interface.sch, usb-pd.sch]
2022-03-28 Add footprint to SoM mechanical model
    [som.sch]
2022-03-28 Change 5V label to 5V_SYS
    [usb-c-interface.sch]
2022-03-28 Change LED to KP-1608EC
    [m2.sch, psu.sch]
2022-03-28 Remove 2 lane DSI connector
    [lcm.sch]
2022-03-28 Add net labels to dsi signals
    [lcm.sch]
2022-03-28 Add 47k resistor to BAT_THERM
    [som.sch]
2022-03-28 Add test points
    [camera-interface.sch, ethernet-controller.sch, hdmi-converter.sch, poe.sch, psu.sch]
2022-03-28 Annotate test points, reimport 510R from global library
    [camera-interface.sch, ethernet-controller.sch, hdmi-converter.sch, poe.sch, psu.sch]
2022-03-28 Annotate diode
    [m2.sch]
2022-03-28 Annotate BAT_THER resistor
    [som.sch]
2022-03-28 Remove J6, import changes to PCB
    [sa800u-baseboard-hw.kicad_pcb]
2022-03-28 Move J6 closer to the edge
    [sa800u-baseboard-hw.kicad_pcb]
2022-03-28 Save current desing, test layout on EC
    [sa800u-baseboard-hw.kicad_pcb]
2022-03-28 Fix labels on GPIO controlling 3V3 and 1V2
    [som.sch]
2022-03-28 Save current status, iterate with position of LT9611
    [sa800u-baseboard-hw.kicad_pcb]
2022-03-28 Fix labels, fix p-mosfet symbol
    [hdmi-converter.sch, psu.sch, som.sch, usb-c-interface.sch, usb-pd.sch]
2022-03-28 Remove diodes on eth leds
    [ethernet-controller.sch]
2022-03-28 Change uSD card holder
    [other-interfaces.sch]
2022-03-28 Add missing label
    [usb-pd.sch]
2022-03-28 Improved placement before layout
    [sa800u-baseboard-hw.kicad_pcb]
2022-03-28 Fix mixed up lanes
    [camera-interface.sch]
2022-03-28 Change diode to larger footprint
    [usb-pd.sch]
2022-03-28 Continue layout, test with EC
    [sa800u-baseboard-hw.kicad_pcb]
2022-03-28 Minor cleanup, fix labels
    [usb-c-interface.sch]
2022-03-28 Fix footprints
2022-03-28 USB-C DGB, host and OTG/DP reowork
    [sa800u-baseboard-hw.kicad_pcb]
2022-03-28 Change D3 to N4148WS
    [hdmi-converter.sch]
2022-03-28 Fix J9 symbol
    [psu.sch]
2022-03-28 Remove one 47uF cap from USB2 VCC, change pin order on U7
    [usb-c-interface.sch]
2022-03-28 Fix 2V7 label naming
    [usb-pd.sch]
2022-03-28 Further work on USB section, changes in layout of HDMI section
    [sa800u-baseboard-hw.kicad_pcb]
2022-03-28 Update footprints courtyards and type (SMD/THT/virt)
2022-03-28 Update footprints to resolve drc error
2022-03-28 Change USB traces to Z90, update footprints
    [sa800u-baseboard-hw.kicad_pcb]
2022-03-28 Fix connection of CC1 and CC2 signals to som (global and local labels mixed)
    [som.sch, usb-c-interface.sch]
2022-03-28 Update labels
    [usb-c-interface.sch]
2022-03-28 Route CSI
    [sa800u-baseboard-hw.kicad_pcb]
2022-03-28 Improve SA800U footprint
2022-03-28 Wire M.2
    [sa800u-baseboard-hw.kicad_pcb]
2022-03-28 PoE section
    [sa800u-baseboard-hw.kicad_pcb]
2022-03-28 Route ethernet, change routing of SD card
    [sa800u-baseboard-hw.kicad_pcb]
2022-03-28 Minor tweaks
    [sa800u-baseboard-hw.kicad_pcb]
2022-03-28 Optimize DBG USB
    [sa800u-baseboard-hw.kicad_pcb]
2022-03-28 Add 1V8_DBG power plane
    [sa800u-baseboard-hw.kicad_pcb]
2022-03-28 Change DP AUX mux
    [sa800u-baseboard-hw.kicad_pcb, usb-c-interface.sch]
2022-03-28 Add 47uF caps to USB2C_5V
    [usb-c-interface.sch]
2022-03-28 USB2 power routed, rework of USB OTG/DP
    [sa800u-baseboard-hw.kicad_pcb]
2022-03-28 Power for uSD
    [sa800u-baseboard-hw.kicad_pcb]
2022-03-28 Add EDS for host USB-C
    [usb-c-interface.sch]
2022-03-28 Eth control signals, improving USB-C host
    [sa800u-baseboard-hw.kicad_pcb]
2022-03-28 Add vertical option for J9, fix PowerPak footprint
2022-03-28 Import changed footprints for J6 and PowerPak. Unify courtyards line thickness
    [sa800u-baseboard-hw.kicad_pcb]
2022-03-28 Continue layout
    [sa800u-baseboard-hw.kicad_pcb, som.sch, usb-c-interface.sch]
2022-03-28 Fix 13k7 symbols
    [psu.sch]
2022-03-28 Modify TSVs connections
    [usb-c-interface.sch]
2022-03-28 Import 13k7 resistors
2022-03-28 Swap USB-C connector placement, fix PoE primary side, route DCDC
    [sa800u-baseboard-hw.kicad_pcb]
2022-03-28 3V8 DCDC power planes
    [sa800u-baseboard-hw.kicad_pcb]
2022-03-28 Fix C75 placement
    [sa800u-baseboard-hw.kicad_pcb]
2022-03-28 Remove gpio/i2c connector, add pullups to I2C10, modify part of the labels
    [som.sch]
2022-03-28 Connect STUSB4500 signals to SoM
    [usb-pd.sch]
2022-03-28 Fix led indicators
    [psu.sch]
2022-03-28 Modify labels for easier routing
    [usb-c-interface.sch]
2022-03-28 Add QWIIC connector and connect it to SoM
    [other-interfaces.sch]
2022-03-28 Import changes from schematics, continue layout
    [sa800u-baseboard-hw.kicad_pcb]
2022-03-28 Source 3V3 DCDC from 5V_SYS
    [psu.sch]
2022-03-28 Continue layout of power part of PCB, cleanup part of high speed traces, route part of low speed signals
    [sa800u-baseboard-hw.kicad_pcb]
2022-03-28 Place RGB led, led indicators circuitry, minor traces fixes
    [sa800u-baseboard-hw.kicad_pcb]
2022-03-28 Connect SP4 to Eth ground, finish PD section
    [sa800u-baseboard-hw.kicad_pcb, sa800u-baseboard-hw.sch]
2022-03-28 Change labels to reflect component placement
    [psu.sch]
2022-03-28 Rearrange labels to simplify routing of buttons
    [som.sch]
2022-03-28 Swap I2C CLK/DAT on U4 to simplify routing
    [hdmi-converter.sch]
2022-03-28 Connect distance to Eth GND cd..
    [sa800u-baseboard-hw.sch]
2022-03-28 Routing lower part of PCB, import changes from sch to PCB
    [sa800u-baseboard-hw.kicad_pcb]
2022-03-28 Rework camera I2C voltage translator. Connect debug RX/TX
    [sa800u-baseboard-hw.kicad_pcb]
2022-03-28 Fix unconnected items on lower part of PCB
    [sa800u-baseboard-hw.kicad_pcb]
2022-03-28 Route I2C to QWIIC connector, continue routing of low speed traces
    [sa800u-baseboard-hw.kicad_pcb]
2022-03-28 Change USB-C PD CC TSV diode to 18V tolerant
    [usb-pd.sch]
2022-03-28 Enumerate parts
    [usb-pd.sch]
2022-03-28 Replace USB-PD TSV diodes
    [sa800u-baseboard-hw.kicad_pcb]
2022-03-28 Change buttons TSV diodes
    [som.sch]
2022-03-28 Change TSV diodes, reroute CSI signals after moving components
    [sa800u-baseboard-hw.kicad_pcb]
2022-03-28 Route remaining low speed signals, mockup routing of VREG_S4A and LVS1A
    [sa800u-baseboard-hw.kicad_pcb]
2022-03-28 New parts annotation
    [som.sch]
2022-03-28 Change TSVs to consolidate bom
    [other-interfaces.sch]
2022-03-28 Wire SD card, clean DRC
    [sa800u-baseboard-hw.kicad_pcb]
2022-03-28 Fix DRC after EC check
    [sa800u-baseboard-hw.kicad_pcb]
2022-03-28 Improve routing of LVS1A and VREG_S4A
    [sa800u-baseboard-hw.kicad_pcb]
2022-03-28 Reorganize schematics, add descriptions in top left corner
    [camera-interface.sch, ethernet-controller.sch, hdmi-converter.sch, lcm.sch, m2.sch, other-interfaces.sch, poe.sch, psu.sch]
2022-03-28 Change all vias to 0.6/0.25mm (drill size from EC DRC info)
    [sa800u-baseboard-hw.kicad_pcb]
2022-03-28 Increase spacing between D27 and U18, reduce D27 brightness to ~20%
    [sa800u-baseboard-hw.kicad_pcb, usb-pd.sch]
2022-03-28 Fix unconnected net on D10
    [usb-c-interface.sch]
2022-03-28 Fix orientation of D10 and alignment of D8
    [sa800u-baseboard-hw.kicad_pcb]
2022-03-28 Fix buttons connections
    [sa800u-baseboard-hw.kicad_pcb, som.sch]
2022-03-28 Increase spacing between U6 and J4
    [sa800u-baseboard-hw.kicad_pcb]
2022-03-28 Change C102 to ceramic, add one more capacitor
    [poe.sch]
2022-03-28 Add capacitors to aux connector, change VDD cap to 25V rated one
    [psu.sch]
2022-03-28 Annotate grounds...
    [som.sch]
2022-03-28 Import changes from schematic
    [sa800u-baseboard-hw.kicad_pcb]
2022-03-28 Fix DS orientation of led p-mosfets
    [psu.sch]
2022-03-28 Add indicator leds, change 1V2_EN and 3V3_EN pins
    [som.sch]
2022-03-28 Fix DS p-mos orientation
    [sa800u-baseboard-hw.kicad_pcb]
2022-03-28 Minor change to improve readability
    [som.sch]
2022-03-28 Add SoM related indicator leds, fix Q14 connections
    [sa800u-baseboard-hw.kicad_pcb]
2022-03-28 Add testpoints to PCB, udpate cache, connect STUSB4500 reset to SoM and pulldown with 10k
    [hdmi-converter.sch, poe.sch, psu.sch, sa800u-baseboard-hw.kicad_pcb, som.sch, usb-pd.sch]
2022-03-28 Add testpoints
    [psu.sch]
2022-03-28 Clear annotation and annotate
    [camera-interface.sch, ethernet-controller.sch, hdmi-converter.sch, lcm.sch, m2.sch, other-interfaces.sch, poe.sch, psu.sch]
2022-03-28 Loclib after anotation
    [hdmi-converter.sch, poe.sch, psu.sch, sa800u-baseboard-hw.kicad_pcb, usb-pd.sch]
2022-03-28 Starded placing silks
    [sa800u-baseboard-hw.kicad_pcb]
2022-03-28 Fix SA800U and camera connector footprint
    [sa800u-baseboard-hw.kicad_pcb]
2022-03-28 Add test points, place them on PCB, add missing labels to test points
    [sa800u-baseboard-hw.kicad_pcb, usb-c-interface.sch]
2022-03-28 Add USB PD label
    [sa800u-baseboard-hw.kicad_pcb]
2022-03-28 Tune PCIe
    [sa800u-baseboard-hw.kicad_pcb]
2022-03-28 Tune PCIe1
    [sa800u-baseboard-hw.kicad_pcb]
2022-03-28 Tune USB-Host traces, tune skew of PCIe0 and 1
    [sa800u-baseboard-hw.kicad_pcb]
2022-03-28 Fix placement of USB Host and OTG/DP labels
    [sa800u-baseboard-hw.kicad_pcb]
2022-03-28 Fix tuning of USB host from SoM side
    [sa800u-baseboard-hw.kicad_pcb]
2022-03-28 Add dip switch to controll Auto ON and USB_Boot functionalities
    [som.sch]
2022-03-28 Reroute USB 3.0, rerouting low speed TBD
    [usb-c-interface.sch]
2022-03-28 Change AUX input connector symbol, update footprint, loclib
    [psu.sch]
2022-03-28 Add missing connection to Vbus on STUSB4500
    [usb-pd.sch]
2022-03-28 Removed SoM doc files
    [Quectel_SA800U-WF_3D_Dimensions_Revision_History.xlsx, Quectel_SA800U-WF_Footprint&Part_Revision_History.xlsx, Quectel_SA800U-WF_PCB_Footprint_AD_V1.1.PcbDoc, Quectel_SA800U-WF_PCB_Footprint_Cadence_V1.1.brd, Quectel_SA800U-WF_PCB_Footprint_PADS_V1.1.pcb, Quectel_SA800U-WF_Pin_Description_and_GPIO_Configuration_V1.0.xlsx, Quectel_SA800U-WF_Pin_Description_and_GPIO_Configuration_V1.1.xlsx, Quectel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]
2022-03-28 SCH: Update naming convention
    [camera-interface.sch, ethernet-controller.sch, hdmi-converter.sch, lcm.sch, m2.sch, other-interfaces.sch, poe.sch, psu.sch]
2022-03-28 Add OSHW signage
    [camera-interface.sch, ethernet-controller.sch, hdmi-converter.sch, lcm.sch, m2.sch, other-interfaces.sch, poe.sch, psu.sch]
2022-03-28 Add PDF schematic
